Normansrule/skyforge-v18-falcon/docs/BUDGET.md

# Running budget: cost, mass, CG, hover and stability (generated)

> Generated by `tools/budget.py` from the BOM, the V18 mass model and the aero model. Re-run after any change.
> Basis: **MODEL (planning LW-PLA 0.80)**.

## Cost

| Bucket | Low USD | High USD |
|---|---|---|
| Aircraft subtotal (V18 rows + added rows, incl. installed FPV) | 816 | 1,353 |
| Contingency (15 % of low / 20 % of high) | 122 | 271 |
| Extras if not owned (radio, monitor, charger, tools) | 341 | 700 |
| **From scratch, excl. printer** | **1,279** | **2,324** |
| Remaining after owned items (none listed) | 1,279 | 2,324 |

V18 BOM aircraft subtotal for comparison: USD 728-1,221.

Spend by stage:

| Stage | Low | High |
|---|---|---|
| S0 | 103 | 187 |
| S1 | 43 | 66 |
| S2 | 338 | 587 |
| S3 | 120 | 218 |
| S5 | 95 | 130 |
| S6 | 42 | 66 |
| S7 | 52 | 112 |
| S8 | 281 | 501 |
| S10 | 83 | 186 |

## Mass and centre of gravity (V18 positions)

| LW-PLA case | Density g/cm3 | All-up g | CG x mm | CG y mm |
|---|---|---|---|---|
| best | 0.60 | 2,515 | 418.7 | -0.3 |
| planning | 0.80 | 2,724 | 418.4 | -0.2 |
| worst_solid_pla | 1.24 | 3,183 | 417.8 | -0.2 |

The old ~1.5 kg finished-aircraft claim is not supported. CG barely moves with density: hardware and skin are both aft.

## Hover

Rotor thrust centroid x330; CG x418.4.

| Motor | Hover thrust g | Bench max needed for PASS (<= 50 %) g | ...for FIX (<= 60 %) g |
|---|---|---|---|
| M1 | 11 | 23 | 19 |
| M2 | 1,351 | 2,701 | 2,251 |
| M3 | 13 | 26 | 21 |
| M4 | 1,349 | 2,698 | 2,248 |

A motor near 0 g means the CG sits on the other rotor row: the front pair is doing almost nothing.

## Wing-borne stability

Neutral-point band (vortex lattice on the V18 planform, `analysis/aero.json`): x285-x332; MAC 544 mm.

Static margin at the current CG: -24.6 % to -15.8 % MAC (negative = unstable). CG window for 5-12 % margin on the forward NP: x219-x257.

See `docs/BALANCE_AND_STABILITY.md` for the balance study.

## Gates

| ID | Gate | Value | Status | Basis |
|---|---|---|---|---|
| G1 | Hover balance: |CG x - rotor centroid x| | 88.4 mm | **STOP** | MODEL (planning LW-PLA 0.80) |
| G2 | Worst motor share of weight (M2) | 49.6 % | **STOP** | MODEL (planning LW-PLA 0.80) |
| G3 | Static margin, most forward neutral point | -24.6 % MAC | **STOP** | MODEL (planning LW-PLA 0.80); NP band x285-332 |
| G4 | Worst-motor hover fraction of measured max thrust | -  | **UNKNOWN** | Stage-2 bench |
| G5 | Hover endurance at 80% of 3300 mAh | - min | **UNKNOWN** | Stage-2 thrust table |
| G6 | Transition peak current vs XT90 class 90 A | - A | **UNKNOWN** | UNKNOWN until Stage 2 |
| G7 | Transition peak vs 70 % of battery label (132 A) | - A | **UNKNOWN** | UNKNOWN until Stage 2 |

**PASS** proceed; **FIX** change something and re-check; **STOP** do not buy the remaining motors or bulk-print until redesigned; **UNKNOWN** the measurement does not exist yet. G1-G3 are model gates (V18 geometry + BOM); G4-G7 need the Stage-2 bench.
