Normansrule/skyforge-v18-falcon/analysis/aero_span_loading.png

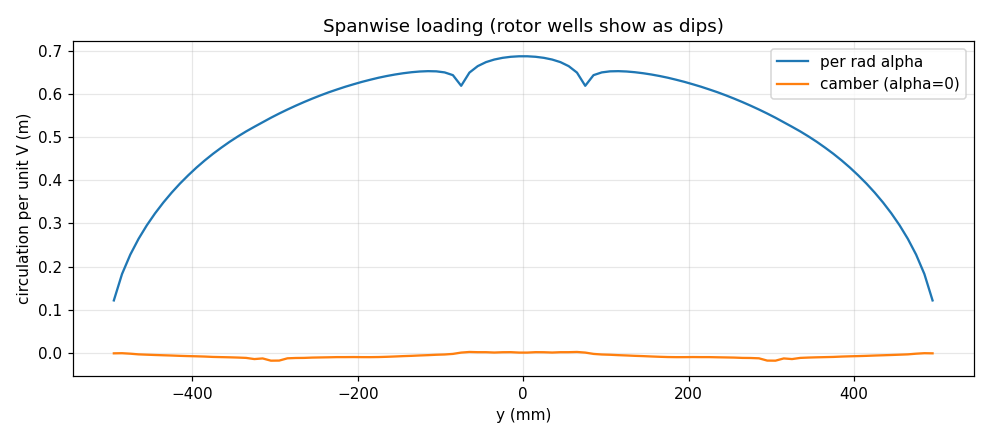
analysis/aero_span_loading.png
