Normansrule/skyforge-v18-falcon/analysis/view_v18.png

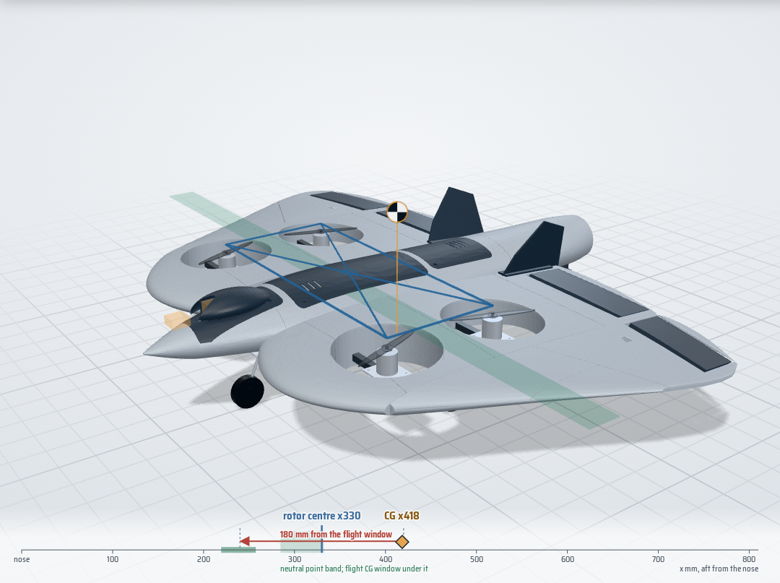
analysis/view_v18.png
