Normansrule/skyforge-v18-falcon/analysis/view_v19f_side.png

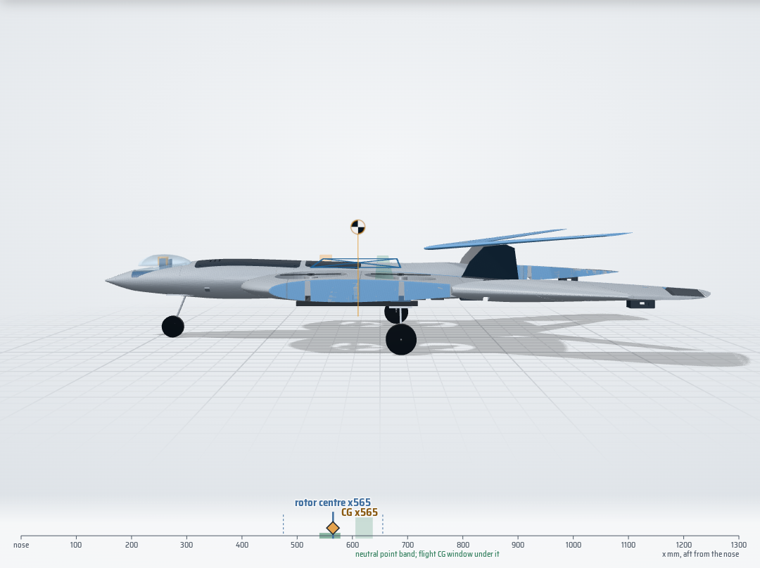
analysis/view_v19f_side.png
