Normansrule/skyforge-v18-falcon/analysis/view_v19r_side.png

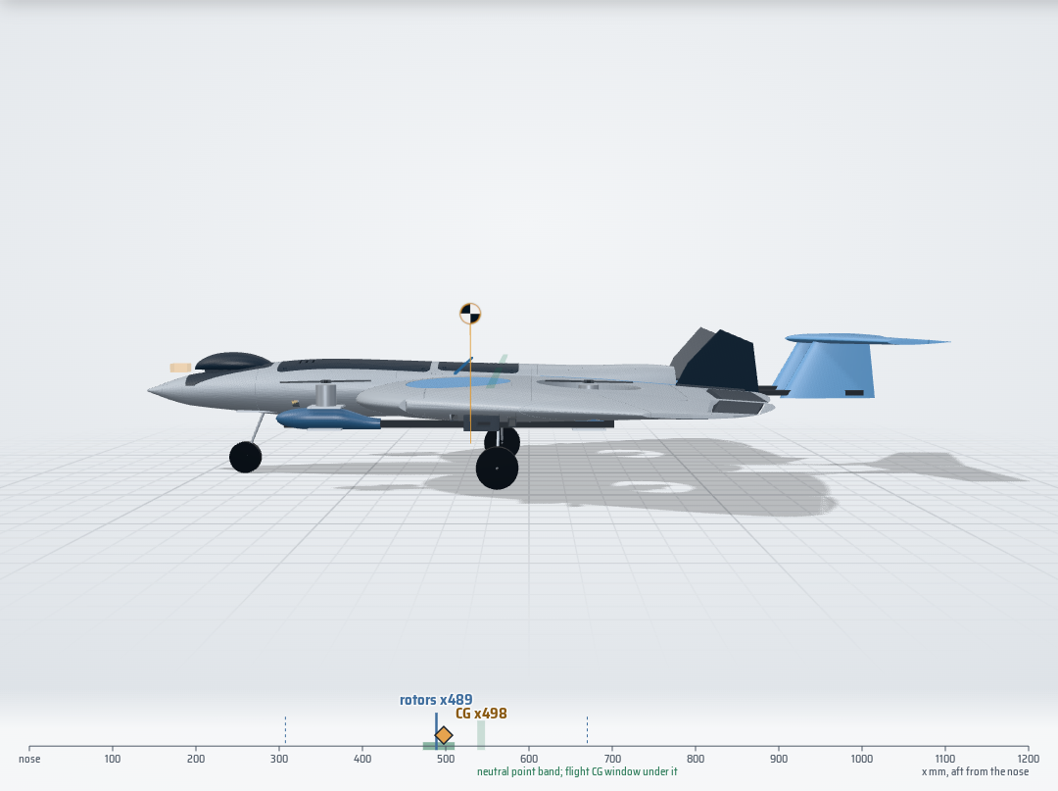
analysis/view_v19r_side.png
