Normansrule/skyforge-v18-falcon/analysis/view_v19r_top.png

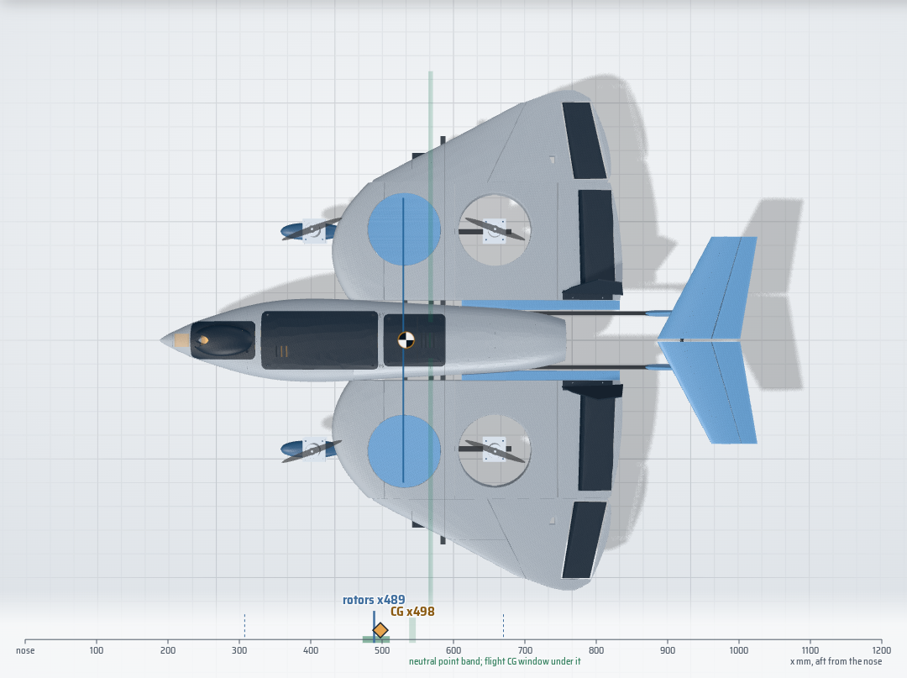
analysis/view_v19r_top.png
