Normansrule/skyforge-v18-falcon/analysis/view_v19s_side.png

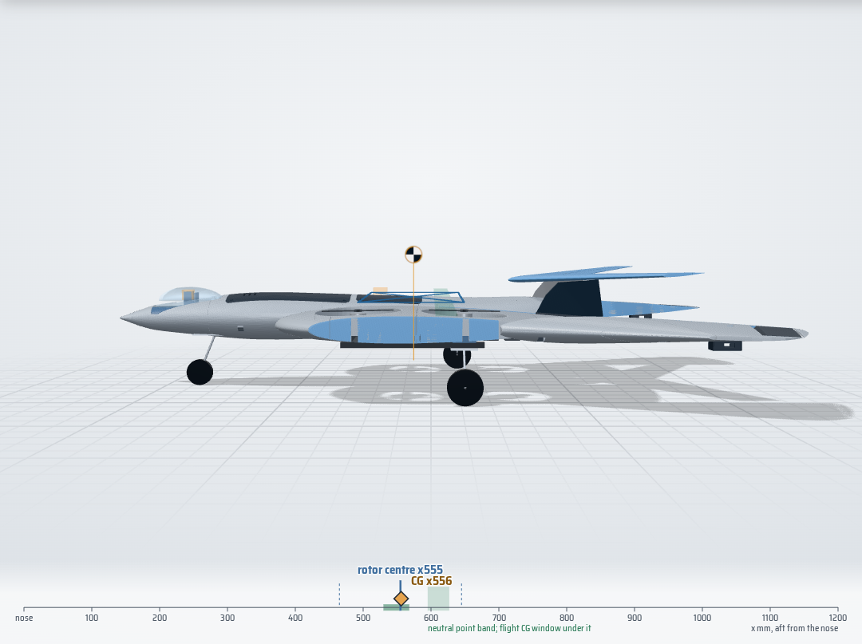
analysis/view_v19s_side.png
