Normansrule/skyforge-v18-falcon/analysis/view_v19w_side.png

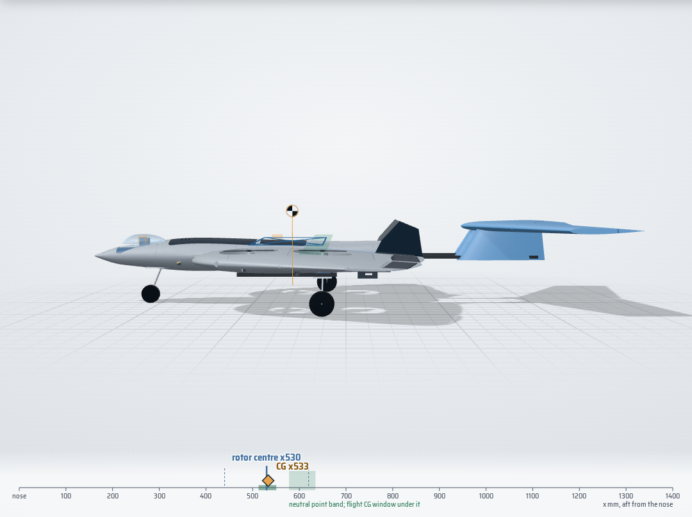
analysis/view_v19w_side.png
