Normansrule/skyforge-v18-falcon/analysis/view_v19w_top.png

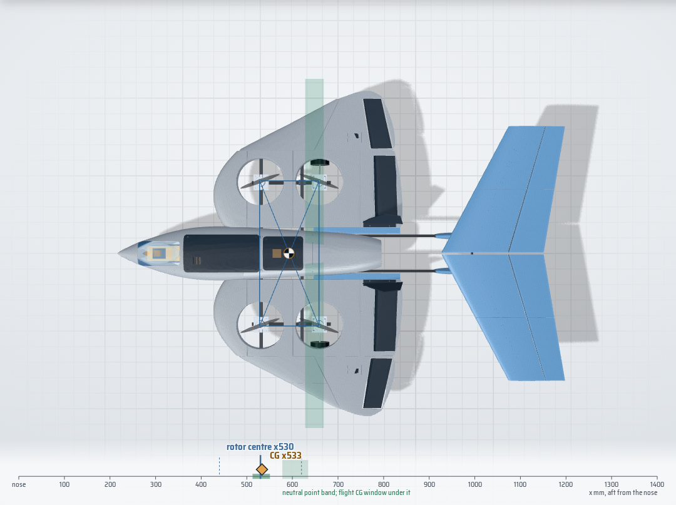
analysis/view_v19w_top.png
