Normansrule/skyforge-v18-falcon/docs/BOM.md

# Bill of materials (generated)

> Generated by `tools/budget.py` from `bom/bom.csv` - edit the CSV, not this file.
> V18 rows come from the V18 `BOM_AND_BUDGET.md` (kept in `cad/v18/`); **ADD** rows close the gaps the brief listed.
> Every named part is a **reference candidate** until fit and performance are verified. Whole-row USD planning
> allowances, excluding shipping/tax; verify variant, stock and price before buying.

Change tags: **ADD** new line, **FIX** tightened gate, **RESCOPE** split out of a vague V18 row, **KEEP** V18 row retained, **ALT** optional (not counted).
Placement: where the mass model puts the item - a V18 object, `xyz:` (assumed, not in the V18 model) or `geometry:` (mass from V18 meshes).

## Propulsion

| ID | Stage | Item | Reference candidate | Buy | Inst. | USD row | Unit g | Dimensions (mm) | Purchase gate | Change |
|---|---|---|---|---|---|---|---|---|---|---|
| P01 | S2 | Lift motor #1 (bench unit) | [EMAX ECO II 2207 2400KV](https://shop.emax-usa.com/products/eco-ii-2207-brushless-motor-1700kv-1900kv-2400kv) | 1 | 1 | 13-20 | 33 (e) | 16x16 mm factory M3 pattern (vendor); V18 envelope 28 dia x 29 | V18: 4S test candidate. Buy ONE first; check the 16x16 M3 pattern against the V18 G10 motor plate DXF. Bench at Stage 2 before buying P02. No 6S substitution. | FIX |
| P02 | S6 | Lift motors #2-4 | [EMAX ECO II 2207 2400KV](https://shop.emax-usa.com/products/eco-ii-2207-brushless-motor-1700kv-1900kv-2400kv) | 3 | 3 | 39-60 | 33 (e) | Same as P01 | Only after the Stage-2 hover gate PASSES in docs/BUDGET.md. Weigh each. | FIX |
| P03 | S2 | Spare lift motor | [EMAX ECO II 2207 2400KV](https://shop.emax-usa.com/products/eco-ii-2207-brushless-motor-1700kv-1900kv-2400kv) | 1 | 0 | 13-20 | 33 (e) | Same as P01 | Stage-2 budget spare. Not installed. | ADD |
| P04 | S2 | Lift props (2 x four-prop packs; second pack is spares) | [APC B5x3E-B4 four-prop pack (2 standard + 2 reverse)](https://www.apcprop.com/product/b5x3e-b4/) | 2 | 4 | 12-16 | 4.5 (e) | 127 dia, 5 mm bore (V18 BOM) | V18: verify hub retention. Never print flight props. Bench this exact prop at Stage 2. | KEEP |
| P06 | S2 | 4-in-1 lift ESC | [Hobbywing XRotor Micro 60A 4-in-1, 30902063](https://www.hobbywing.com/en/products/xrotor-micro-60a-4in1-blheli-32-dshot1200117) | 1 | 1 | 65-100 | 15 (v) | 52 x 42 x 6.6 published case; V18 keep-out 54 x 46 x 14 | Per-channel rating is NOT an aircraft bus rating. Stock XT60 not assumed adequate. Pad order is not assumed to match ArduPilot motor order. | KEEP |
| P07 | S5 | Rear EDF 64 mm | [Freewing E7206 64 mm 4S EDF Mark II](https://www.freewingmodel.com/747.html) | 1 | 1 | 60-85 | 142 (v) | 142 g published; V18 housing keep-out 72 dia x 78 | V18: factory ear and housing fit still required against EDF_saddle x2 and the outrigger connectors. | KEEP |
| P08 | S5 | EDF ESC | [Hobbywing Skywalker 60A V2](https://www.hobbywingdirect.com/products/skywalker-esc-60a) | 1 | 1 | 35-45 | 55 (e) | V18 keep-out 73 x 30 x 12 plus margin | Isolate the unused BEC positive; no reverse-thrust feature configured. Signal + ground only to FC S11. | KEEP |

## Power

| ID | Stage | Item | Reference candidate | Buy | Inst. | USD row | Unit g | Dimensions (mm) | Purchase gate | Change |
|---|---|---|---|---|---|---|---|---|---|---|
| E01 | S2 | Flight battery 4S 3300 mAh | [4S 3300 mAh standard LiPo (reference: CNHL 3300 4S 40C, 136 x 44 x 31, 369 g)](https://chinahobbyline.com/products/cnhl-3300mah-14-8v-4s-40c-lipo-battery-with-xt60-plug) | 1 | 1 | 40-65 | 369 (v) | Case <= 140 x 50 x 38 before leads (V18 keep-out 140 x 50 x 38) | Discharge rating, connector and wiring from MEASURED total current; the C label alone is insufficient. The keep-out leaves only ~4 mm of fore/aft slide, so the battery is not a CG trim tool in V18. | FIX |
| E02 | S2 | Total-current + voltage monitor (hall) | [Mauch 075 HS-200-LV (200 A, 2-6S)](https://mauch-electronic.com/products/075-hs-200-lv) | 1 | 1 | 41-55 | 20 (e) | Measure; 10 AWG leads + DF13-6 cable | Installed between battery and star so it sees lift + EDF + avionics. F405 WING ADC pads are 3.3 V: confirm output <= 3.3 V at max expected current. Calibrate against the bench watt meter at Stage 2. | ADD |
| E03 | ALT | Budget alternative total-current sensor | [ACS758LCB-200U hall module](https://www.amazon.com/s?k=ACS758LCB-200U+module) | 0 | 0 | 8-15 | 10 (e) | Module ~30 x 20 | Only if E02 is not bought. ~20 mV/A with ~0.6 V offset -> 3.3 V near 135 A; clamp to 3.3 V and calibrate against a meter. | ALT |
| E04 | S8 | Servo UBEC 5.0 V | [Hobbywing UBEC 10A AIR, 30603000](https://www.hobbywing.com/en/products/ubec-10a-2-6s152) | 1 | 1 | 25-40 | 36 (v) | 43.1 x 32.3 x 12.5 (vendor); V18 keep-out 48 x 38 x 16 | Set and MEASURE 5.0 V under servo load. Do not buy the CAR version (starts at 6 V). Feeds the isolated servo bus only. | KEEP |
| E05 | S2 | Main power connectors | [Genuine AMASS XT90 pairs x2, XT60 pairs x4, 3.5 mm bullets x6](https://www.amazon.com/s?k=amass+xt90+xt60+connector) | 1 | 1 | 15-25 | 30 (e) | - | Split out of the V18 'power harness' row. Final connector class from measured simultaneous current. | RESCOPE |
| E06 | S2 | Wire + heat-shrink | [Silicone wire 10 AWG (main/lift), 12 AWG (EDF), 18 AWG (branches), 22-26 AWG signal; heat-shrink](https://www.amazon.com/s?k=10+awg+silicone+wire+red+black) | 1 | 1 | 15-30 | 60 (e) | See docs/HARNESS.md cut list | Lengths from the V18-position harness cut list; gauge from measured current. | RESCOPE |
| E07 | S2 | Low-ESR bulk caps x2 (35 V) | [Panasonic FR 1000 uF 35 V (EEU-FR1V102) or equivalent](https://www.digikey.com/en/products/result?keywords=EEU-FR1V102) | 2 | 2 | 3-6 | 5 (e) | ~12.5 dia x 20 | One at the 4-in-1 input and one at the EDF ESC input; leads < 20 mm. | RESCOPE |
| E08 | S8 | FC-branch protection | [Inline mini-blade fuse holder (16-18 AWG) + 3 A and 5 A fuses](https://www.amazon.com/s?k=inline+mini+blade+fuse+holder+16+awg) | 1 | 1 | 4-8 | 4 (e) | - | Size after measuring avionics + video current at Stage 8. | RESCOPE |
| E09 | S8 | Video 5 V supply | [FC PDB VTX BEC set to 5 V (no purchase) or a separate 5 V micro-BEC](https://ardupilot.org/plane/docs/common-speedybeef405wing.html) | 0 | 0 | 0-8 | 0 (-) | - | MEASURE 5.0 V on the video rail BEFORE connecting the VTX (3.5-5.5 V max). | ADD |

## Avionics

| ID | Stage | Item | Reference candidate | Buy | Inst. | USD row | Unit g | Dimensions (mm) | Purchase gate | Change |
|---|---|---|---|---|---|---|---|---|---|---|
| A01 | S8 | Flight controller + PDB | [Original full-size SpeedyBee F405 WING APP (not MINI, not unverified V2)](https://ardupilot.org/plane/docs/common-speedybeef405wing.html) | 1 | 1 | 50-80 | 35 (v) | FC 52 x 32 x 19 (vendor); V18 keep-out 54 x 34 x 24 | ArduPlane target SpeedyBeeF405WING. PDB shunt (90 A cont) sees only the FC branch; E02 is the total monitor. | KEEP |
| A02 | S8 | FC isolation | [Printed TPU pad (cad/interface SF_FC_iso_pad_TPU) + spare M3 soft grommets](https://www.amazon.com/s?k=m3+anti+vibration+grommets+flight+controller) | 1 | 1 | 5-10 | 6 (e) | Fits the V18 FC keep-out | PASS: ArduPilot VIBE X/Y/Z < 30 m/s^2 and zero clip counts in a restrained props-on test. | ADD |
| A03 | S8 | ELRS receiver | [RadioMaster RP1 V2 2.4 GHz (FCC)](https://radiomasterrc.com/products/rp1-expresslrs-2-4ghz-nano-receiver) | 1 | 1 | 19-25 | 1.5 (e) | Nano receiver + U.FL antenna; V18 antenna keep-out 24 x 20 x 10 | 5 V CRSF. Keep the antenna clear of carbon shadow. Uses an ESP8285 MCU - the commercial link is not ESP-free. | KEEP |
| A04 | S8 | GNSS + compass | [Supported UART M10 GNSS + I2C compass, case <= 26 x 26 x 13](https://ardupilot.org/plane/docs/common-positioning-landing-page.html) | 1 | 1 | 25-50 | 10 (e) | V18 external keep-out 26 x 26 x 13 | V18: choose an actual compatible 5 V module; the old EOL module is not prescribed. Nonconductive external pad; check compass vs lift + EDF current (COMPASS_MOT). | KEEP |
| A05 | S8 | Airspeed sensor + pitot | [Matek ASPD-4525 with pitot and tubing](https://www.mateksys.com/?portfolio=aspd-4525) | 1 | 1 | 35-65 | 9 (e) | 4-5.5 V I2C module | Pitot outside rotor flow. Do not blow forcefully into the sensor. Location not in the V18 model - placement here is an assumption. | KEEP |
| A06 | S8 | Lost-model alarm (self-powered) | [VIFLY Finder 2](https://www.getfpv.com/vifly-finder-2-drone-buzzer.html) | 1 | 1 | 10-14 | 5 (e) | - | Tested at every power-up; never arm without it (docs/WIRING.md section 11). | ADD |
| A07 | S1 | Servo #1 (fit unit) | [EMAX ES08MA II metal gear micro servo](https://shop.emax-usa.com/products/emx-sv-0275-es08ma-ii-metal-analog-servo) | 1 | 1 | 8-18 | 12 (v) | ~32 x 11.5 x 24 body - verify in SP1 | V18: fit ONE before buying five. Substitutes (HS-65MG class) need dimensional AND torque checks. | KEEP |
| A08 | S7 | Servos #2-5 | [EMAX ES08MA II metal gear micro servo](https://shop.emax-usa.com/products/emx-sv-0275-es08ma-ii-metal-analog-servo) | 4 | 4 | 32-72 | 12 (v) | Same as A07 | Only after A07 passes fit + motion at Stage 1. Nose-steering servo location is not in the V18 model (placement assumed). | KEEP |
| A09 | S7 | Hinges, horns, pushrods, straps, backers | [12 hinges; 4 slop-free flight-control linkages; nose-steering linkage; 2 battery straps + nonslip pad; small balsa/G10 backers](https://www.amazon.com/s?k=rc+ca+hinges+pushrod+clevis+kit) | 1 | 1 | 20-40 | 40 (e) | - | V18 row. Horn/pushrod clearance is a Stage-7 check on BOTH sides; battery restraint is a Stage-4 pull test. | KEEP |
| A11 | S8 | Isolated servo 5 V bus | [Perfboard + 2.54 mm headers + 22 AWG](https://www.amazon.com/s?k=perfboard+2.54mm+header+pins) | 1 | 1 | 3-6 | 5 (e) | - | UBEC + only. FC servo-rail + is not connected to this bus. | ADD |

## FPV

| ID | Stage | Item | Reference candidate | Buy | Inst. | USD row | Unit g | Dimensions (mm) | Purchase gate | Change |
|---|---|---|---|---|---|---|---|---|---|---|
| V01 | S1 | FPV camera | [RunCam Phoenix 2 19 mm analog](https://shop.runcam.com/runcam-phoenix-2/) | 1 | 1 | 30-40 | 9 (v) | 19 x 19 body; V18 keep-out 20 x 19 x 19 | 5-36 V camera, ~9 g (V18 BOM). CAM_19mm_cradle fit + field-of-view check at Stage 1. | KEEP |
| V02 | S8 | VTX + antenna | [5 V analog VTX + matching antenna (electrical reference RunCam TX200U-US 3.5-5.5 V)](https://www.runcam.com/download/RunCam-TX200U-US-manual.pdf) | 1 | 1 | 25-45 | 6 (e) | V18 keep-out 42 x 26 x 14 | Replacement must be checked for input range, case, video and RF compliance. Antenna on BEFORE power. | KEEP |

## Structure

| ID | Stage | Item | Reference candidate | Buy | Inst. | USD row | Unit g | Dimensions (mm) | Purchase gate | Change |
|---|---|---|---|---|---|---|---|---|---|---|
| S01 | S3 | Carbon square tube 10 x 10 (2 x 1 m) | [Pultruded 10 x 10, ~1 mm wall candidate](https://carbonkevlarsupply.com/products/2-pultruded-square-carbon-fiber-tube-10mm-x-10mm-x-1000mm) | 2 | 1 | 22-40 | 0 (geo) | Cut list (cad/v18/carbon_cut_list.json): crossrails 620 + 820, gear crossbar 340 | V18 row (split by section). Measure wall/bore - 'round-centre' pultrusions differ from a 1 mm square wall. Prove clamp and bending strength at Stage 3. | KEEP |
| S02 | S3 | Carbon square tube 8 x 8 (2 x 1 m) | [Pultruded 8 x 8, ~1 mm wall candidate](https://carbonkevlarsupply.com/search?q=8mm+square+carbon+tube) | 2 | 1 | 18-30 | 0 (geo) | Cut list: keels 2 x 420, EDF outriggers 2 x 174 | Same as S01. | KEEP |
| S03 | S3 | G10/FR4 sheet stock 2.5 mm + 2.0 mm | [2.5 mm (motor plates/backers/gear plates/nose bridge) + 2.0 mm (cassette supports, EDF fittings)](https://www.beeplastic.com/products/g10-fr4-fiberglass-epoxy-plate-3240-0-5-5mm) | 1 | 1 | 20-40 | 0 (geo) | Cut profiles: cad/v18/dxf (15 plates, holes as modelled) | V18 row. Printed templates are not flight mounts. Imperial 3/32 in (2.38 mm) is not 2.5 mm - check screw lengths if substituted. | KEEP |
| R01 | S3 | Repo interface parts (installed) | [10 crossing-clamp plates + 2 belly straps (G10 2.0), 2 EDF ear brackets (PA-CF), FC TPU pad - see cad/interface/out/manifest.json](repo:cad/interface/out/manifest.json) | 0 | 1 | 0-0 | 30 (c) | G10 from S03 stock, filament from C05; mass = CAD volume x density | Cut/print at Stage 3 (clamps, straps), Stage 5 (EDF brackets) and Stage 8 (FC pad). Not part of the V18 1,297 cm3 polymer figure. | ADD |
| S05 | S3 | Fixed tricycle landing gear | [4 mm-class spring-steel legs; 2 x 60 mm mains, 1 x 48-50 mm nose; collars, axle bearings, steering tiller](https://www.amazon.com/s?k=rc+airplane+spring+steel+landing+gear+4mm) | 1 | 1 | 35-65 | 75 (e) | Main track 360 at crossbar x385; nose axle x150 (V18 layout) | V18 row. Proof-load at Stage 3 on the carbon/G10 structure without skin. | KEEP |

## Fasteners

| ID | Stage | Item | Reference candidate | Buy | Inst. | USD row | Unit g | Dimensions (mm) | Purchase gate | Change |
|---|---|---|---|---|---|---|---|---|---|---|
| F01 | S0 | M2 x 0.4 service screws + nuts + washers | [Stainless M2 x 6/8/10/12 + plain M2 hex nuts](https://www.amazon.com/s?k=m2+x+0.4+stainless+socket+screw+nut+kit) | 1 | 1 | 8-12 | 15 (e) | - | Confirm owned '2.0 mm' screws are M2 x 0.4 MACHINE screws. Nut pockets take plain M2 nuts - NOT heat-set inserts. Owned M2 reduces this row. | FIX |
| F02 | S3 | M3 structural hardware | [A2-70 / 10.9 M3 SHCS + nylocks + washers (motor plates use factory M3)](https://www.amazon.com/s?k=m3+socket+head+nylock+washer+kit) | 1 | 1 | 8-15 | 20 (e) | - | Check engagement through plate + rail + backing stack. | FIX |
| F03 | S3 | M4 gear hardware | [M4 SHCS + nylocks + washers](https://www.amazon.com/s?k=m4+socket+head+nylock+kit) | 1 | 1 | 4-8 | 10 (e) | - | Gear only. | FIX |

## Consumables

| ID | Stage | Item | Reference candidate | Buy | Inst. | USD row | Unit g | Dimensions (mm) | Purchase gate | Change |
|---|---|---|---|---|---|---|---|---|---|---|
| C01 | S3 | Threadlocker medium removable | [Loctite 243](https://www.amazon.com/s?k=loctite+243) | 1 | 0 | 5-8 | 0 (-) | - | Metal-to-metal only; keep off printed parts. | ADD |
| C02 | S1 | CA glue + activator | [Thin + medium CA + activator](https://www.amazon.com/s?k=ca+glue+thin+medium+activator) | 1 | 0 | 5-8 | 0 (-) | - | Adhesive mass is carried in C03. | ADD |
| C03 | S3 | Epoxy 5-min + 30-min | [5-min and 30-min epoxy](https://www.amazon.com/s?k=30+minute+epoxy+hobby) | 1 | 1 | 8-12 | 20 (e) | All installed adhesive | 30-min for carbon/G10 bonds. | ADD |
| C05 | S0 | Filament | [LW-PLA gray + charcoal for skins/controls; PETG for trays, cassettes, saddles, ducts; TPU 95A for the FC carrier](https://www.amazon.com/s?k=lw-pla+filament) | 1 | 0 | 35-55 | 0 (-) | Polymer mass from V18 volumes x calibrated density | V18 row split (adhesives itemized separately). Calibrate LW-PLA and WEIGH coupons at Stage 1. | RESCOPE |
| C07 | S6 | Clear cockpit window | [Thin clear PETG or polycarbonate sheet](https://www.amazon.com/s?k=clear+petg+sheet+0.5mm) | 1 | 1 | 3-6 | 4 (e) | - | V18 row. | KEEP |
| C06 | S10 | Light finish + decals | [Lightweight vinyl markings / thin paint](https://www.amazon.com/s?k=rc+airplane+vinyl+decal+sheet) | 1 | 1 | 3-6 | 8 (e) | - | Added last; reweigh and rebalance after. | KEEP |

## Extras

| ID | Stage | Item | Reference candidate | Buy | Inst. | USD row | Unit g | Dimensions (mm) | Purchase gate | Change |
|---|---|---|---|---|---|---|---|---|---|---|
| X01 | S0 | Digital calipers | [150 mm digital caliper](https://www.amazon.com/s?k=digital+caliper+150mm) | 1 | 0 | 15-30 | 0 (-) | - | Skip if owned. | KEEP |
| X02 | S0 | Scales | [0.1 g pocket scale + 5 kg kitchen scale](https://www.amazon.com/s?k=0.1g+digital+pocket+scale) | 1 | 0 | 15-30 | 0 (-) | - | Skip if owned. | KEEP |
| X03 | S2 | Multimeter | [Auto-ranging DMM](https://www.amazon.com/s?k=auto+ranging+multimeter) | 1 | 0 | 20-40 | 0 (-) | - | Skip if owned. | KEEP |
| X04 | S2 | Inline watt meter >= 100 A | [Inline power analyzer rated above measured peak](https://www.amazon.com/s?k=rc+watt+meter+150a) | 1 | 0 | 20-40 | 0 (-) | - | Reference for calibrating E02. | ADD |
| X05 | S2 | Guarded thrust stand (ESP-free) | [Arduino Nano + HX711 + 5 kg load cell + guard; firmware in firmware/thrust_stand](https://www.amazon.com/s?k=hx711+5kg+load+cell) | 1 | 0 | 25-60 | 0 (-) | - | Prop guard and clamping are mandatory; nobody in the prop plane. | ADD |
| X06 | S2 | Servo tester (bench throttle) | [3-mode PWM servo tester](https://www.amazon.com/s?k=servo+tester+pwm) | 1 | 0 | 6-10 | 0 (-) | - | Optional - the thrust-stand firmware can drive the ESC itself. | ADD |
| X07 | S2 | 4S balance charger + LiPo bag | [4S-capable balance charger and charging supplies](https://www.amazon.com/s?k=lipo+balance+charger+4s) | 1 | 0 | 50-100 | 0 (-) | - | Skip if owned. | KEEP |
| X08 | S8 | ELRS transmitter + batteries | [Compatible commercial ELRS 2.4 GHz transmitter](https://radiomasterrc.com/) | 1 | 0 | 80-150 | 0 (-) | - | Skip if owned. | KEEP |
| X09 | S10 | FPV monitor / goggles | [Analog 5.8 GHz monitor or goggles](https://www.getfpv.com/) | 1 | 0 | 80-180 | 0 (-) | - | First flights are NOT immersive FPV. | KEEP |
| X10 | S0 | Soldering station | [Temperature-controlled iron capable of 10 AWG](https://www.amazon.com/s?k=temperature+controlled+soldering+station+80w) | 1 | 0 | 30-60 | 0 (-) | - | Skip if owned. | KEEP |

Mass basis: (v) vendor listing, (e) estimate - weigh it, (geo) from V18 meshes. Measured masses go in `config/measurements.json`.
