Normansrule/skyforge-v18-falcon/bom/bom.csv

id | stage | group | item | reference_candidate | buy_qty | installed_qty | row_usd_low | row_usd_high | unit_mass_g | mass_basis | dims_mm | supplier | url | purchase_gate | change | placement
P01 | S2 | Propulsion | Lift motor #1 (bench unit) | EMAX ECO II 2207 2400KV | 1 | 1 | 13 | 20 | 33 | estimate | 16x16 mm factory M3 pattern (vendor); V18 envelope 28 dia x 29 | EMAX USA | https://shop.emax-usa.com/products/eco-ii-2207-brushless-motor-1700kv-1900kv-2400kv | V18: 4S test candidate. Buy ONE first; check the 16x16 M3 pattern against the V18 G10 motor plate DXF. Bench at Stage 2 before buying P02. No 6S substitution. | FIX | PURCHASE_M1_2207_envelope
P02 | S6 | Propulsion | Lift motors #2-4 | EMAX ECO II 2207 2400KV | 3 | 3 | 39 | 60 | 33 | estimate | Same as P01 | EMAX USA | https://shop.emax-usa.com/products/eco-ii-2207-brushless-motor-1700kv-1900kv-2400kv | Only after the Stage-2 hover gate PASSES in docs/BUDGET.md. Weigh each. | FIX | PURCHASE_M2_2207_envelope;PURCHASE_M3_2207_envelope;PURCHASE_M4_2207_envelope
P03 | S2 | Propulsion | Spare lift motor | EMAX ECO II 2207 2400KV | 1 | 0 | 13 | 20 | 33 | estimate | Same as P01 | EMAX USA | https://shop.emax-usa.com/products/eco-ii-2207-brushless-motor-1700kv-1900kv-2400kv | Stage-2 budget spare. Not installed. | ADD
P04 | S2 | Propulsion | Lift props (2 x four-prop packs; second pack is spares) | APC B5x3E-B4 four-prop pack (2 standard + 2 reverse) | 2 | 4 | 12 | 16 | 4.5 | estimate | 127 dia, 5 mm bore (V18 BOM) | APC Propellers | https://www.apcprop.com/product/b5x3e-b4/ | V18: verify hub retention. Never print flight props. Bench this exact prop at Stage 2. | KEEP | NO_PRINT_PURCHASED_PROP_M1_REFERENCE_ONLY;NO_PRINT_PURCHASED_PROP_M2_REFERENCE_ONLY;NO_PRINT_PURCHASED_PROP_M3_REFERENCE_ONLY;NO_PRINT_PURCHASED_PROP_M4_REFERENCE_ONLY
P06 | S2 | Propulsion | 4-in-1 lift ESC | Hobbywing XRotor Micro 60A 4-in-1, 30902063 | 1 | 1 | 65 | 100 | 15 | vendor | 52 x 42 x 6.6 published case; V18 keep-out 54 x 46 x 14 | Hobbywing | https://www.hobbywing.com/en/products/xrotor-micro-60a-4in1-blheli-32-dshot1200117 | Per-channel rating is NOT an aircraft bus rating. Stock XT60 not assumed adequate. Pad order is not assumed to match ArduPilot motor order. | KEEP | KEEP_OUT_LIFT_ESC_54x46x14
P07 | S5 | Propulsion | Rear EDF 64 mm | Freewing E7206 64 mm 4S EDF Mark II | 1 | 1 | 60 | 85 | 142 | vendor | 142 g published; V18 housing keep-out 72 dia x 78 | Freewing | https://www.freewingmodel.com/747.html | V18: factory ear and housing fit still required against EDF_saddle x2 and the outrigger connectors. | KEEP | KEEP_OUT_EDF_72mm_HOUSING_KEEP_OUT
P08 | S5 | Propulsion | EDF ESC | Hobbywing Skywalker 60A V2 | 1 | 1 | 35 | 45 | 55 | estimate | V18 keep-out 73 x 30 x 12 plus margin | Hobbywing Direct | https://www.hobbywingdirect.com/products/skywalker-esc-60a | Isolate the unused BEC positive; no reverse-thrust feature configured. Signal + ground only to FC S11. | KEEP | KEEP_OUT_EDF_ESC_73x30x12_plus_margin
E01 | S2 | Power | Flight battery 4S 3300 mAh | 4S 3300 mAh standard LiPo (reference: CNHL 3300 4S 40C, 136 x 44 x 31, 369 g) | 1 | 1 | 40 | 65 | 369 | vendor | Case <= 140 x 50 x 38 before leads (V18 keep-out 140 x 50 x 38) | CNHL | https://chinahobbyline.com/products/cnhl-3300mah-14-8v-4s-40c-lipo-battery-with-xt60-plug | Discharge rating, connector and wiring from MEASURED total current; the C label alone is insufficient. The keep-out leaves only ~4 mm of fore/aft slide, so the battery is not a CG trim tool in V18. | FIX | KEEP_OUT_BATTERY_MAX_140x50x38
E02 | S2 | Power | Total-current + voltage monitor (hall) | Mauch 075 HS-200-LV (200 A, 2-6S) | 1 | 1 | 41 | 55 | 20 | estimate | Measure; 10 AWG leads + DF13-6 cable | Mauch Electronic | https://mauch-electronic.com/products/075-hs-200-lv | Installed between battery and star so it sees lift + EDF + avionics. F405 WING ADC pads are 3.3 V: confirm output <= 3.3 V at max expected current. Calibrate against the bench watt meter at Stage 2. | ADD | xyz:287,0,10
E03 | ALT | Power | Budget alternative total-current sensor | ACS758LCB-200U hall module | 0 | 0 | 8 | 15 | 10 | estimate | Module ~30 x 20 | Amazon (commodity) | https://www.amazon.com/s?k=ACS758LCB-200U+module | Only if E02 is not bought. ~20 mV/A with ~0.6 V offset -> 3.3 V near 135 A; clamp to 3.3 V and calibrate against a meter. | ALT
E04 | S8 | Power | Servo UBEC 5.0 V | Hobbywing UBEC 10A AIR, 30603000 | 1 | 1 | 25 | 40 | 36 | vendor | 43.1 x 32.3 x 12.5 (vendor); V18 keep-out 48 x 38 x 16 | Hobbywing | https://www.hobbywing.com/en/products/ubec-10a-2-6s152 | Set and MEASURE 5.0 V under servo load. Do not buy the CAR version (starts at 6 V). Feeds the isolated servo bus only. | KEEP | KEEP_OUT_SERVO_BEC_48x38x16
E05 | S2 | Power | Main power connectors | Genuine AMASS XT90 pairs x2, XT60 pairs x4, 3.5 mm bullets x6 | 1 | 1 | 15 | 25 | 30 | estimate | - | Amazon (commodity) | https://www.amazon.com/s?k=amass+xt90+xt60+connector | Split out of the V18 'power harness' row. Final connector class from measured simultaneous current. | RESCOPE | KEEP_OUT_BATTERY_MAX_140x50x38:3;KEEP_OUT_LIFT_ESC_54x46x14:1;KEEP_OUT_EDF_ESC_73x30x12_plus_margin:1
E06 | S2 | Power | Wire + heat-shrink | Silicone wire 10 AWG (main/lift), 12 AWG (EDF), 18 AWG (branches), 22-26 AWG signal; heat-shrink | 1 | 1 | 15 | 30 | 60 | estimate | See docs/HARNESS.md cut list | Amazon (commodity) | https://www.amazon.com/s?k=10+awg+silicone+wire+red+black | Lengths from the V18-position harness cut list; gauge from measured current. | RESCOPE | KEEP_OUT_BATTERY_MAX_140x50x38:2;KEEP_OUT_LIFT_ESC_54x46x14:2;KEEP_OUT_EDF_ESC_73x30x12_plus_margin:2;KEEP_OUT_FC_54x34x24:1
E07 | S2 | Power | Low-ESR bulk caps x2 (35 V) | Panasonic FR 1000 uF 35 V (EEU-FR1V102) or equivalent | 2 | 2 | 3 | 6 | 5 | estimate | ~12.5 dia x 20 | Digi-Key | https://www.digikey.com/en/products/result?keywords=EEU-FR1V102 | One at the 4-in-1 input and one at the EDF ESC input; leads < 20 mm. | RESCOPE | KEEP_OUT_LIFT_ESC_54x46x14;KEEP_OUT_EDF_ESC_73x30x12_plus_margin
E08 | S8 | Power | FC-branch protection | Inline mini-blade fuse holder (16-18 AWG) + 3 A and 5 A fuses | 1 | 1 | 4 | 8 | 4 | estimate | - | Amazon (commodity) | https://www.amazon.com/s?k=inline+mini+blade+fuse+holder+16+awg | Size after measuring avionics + video current at Stage 8. | RESCOPE | KEEP_OUT_FC_54x34x24
E09 | S8 | Power | Video 5 V supply | FC PDB VTX BEC set to 5 V (no purchase) or a separate 5 V micro-BEC | 0 | 0 | 0 | 8 | 0 | none | - | ArduPilot docs | https://ardupilot.org/plane/docs/common-speedybeef405wing.html | MEASURE 5.0 V on the video rail BEFORE connecting the VTX (3.5-5.5 V max). | ADD
A01 | S8 | Avionics | Flight controller + PDB | Original full-size SpeedyBee F405 WING APP (not MINI, not unverified V2) | 1 | 1 | 50 | 80 | 35 | vendor | FC 52 x 32 x 19 (vendor); V18 keep-out 54 x 34 x 24 | ArduPilot docs | https://ardupilot.org/plane/docs/common-speedybeef405wing.html | ArduPlane target SpeedyBeeF405WING. PDB shunt (90 A cont) sees only the FC branch; E02 is the total monitor. | KEEP | KEEP_OUT_FC_54x34x24
A02 | S8 | Avionics | FC isolation | Printed TPU pad (cad/interface SF_FC_iso_pad_TPU) + spare M3 soft grommets | 1 | 1 | 5 | 10 | 6 | estimate | Fits the V18 FC keep-out | Amazon (commodity) | https://www.amazon.com/s?k=m3+anti+vibration+grommets+flight+controller | PASS: ArduPilot VIBE X/Y/Z < 30 m/s^2 and zero clip counts in a restrained props-on test. | ADD | KEEP_OUT_FC_54x34x24
A03 | S8 | Avionics | ELRS receiver | RadioMaster RP1 V2 2.4 GHz (FCC) | 1 | 1 | 19 | 25 | 1.5 | estimate | Nano receiver + U.FL antenna; V18 antenna keep-out 24 x 20 x 10 | RadioMaster | https://radiomasterrc.com/products/rp1-expresslrs-2-4ghz-nano-receiver | 5 V CRSF. Keep the antenna clear of carbon shadow. Uses an ESP8285 MCU - the commercial link is not ESP-free. | KEEP | KEEP_OUT_RX_antenna_free_zone
A04 | S8 | Avionics | GNSS + compass | Supported UART M10 GNSS + I2C compass, case <= 26 x 26 x 13 | 1 | 1 | 25 | 50 | 10 | estimate | V18 external keep-out 26 x 26 x 13 | ArduPilot docs | https://ardupilot.org/plane/docs/common-positioning-landing-page.html | V18: choose an actual compatible 5 V module; the old EOL module is not prescribed. Nonconductive external pad; check compass vs lift + EDF current (COMPASS_MOT). | KEEP | KEEP_OUT_GPS_mount_EXTERNAL_TBD
A05 | S8 | Avionics | Airspeed sensor + pitot | Matek ASPD-4525 with pitot and tubing | 1 | 1 | 35 | 65 | 9 | estimate | 4-5.5 V I2C module | Mateksys | https://www.mateksys.com/?portfolio=aspd-4525 | Pitot outside rotor flow. Do not blow forcefully into the sensor. Location not in the V18 model - placement here is an assumption. | KEEP | xyz:130,0,20
A06 | S8 | Avionics | Lost-model alarm (self-powered) | VIFLY Finder 2 | 1 | 1 | 10 | 14 | 5 | estimate | - | GetFPV | https://www.getfpv.com/vifly-finder-2-drone-buzzer.html | Tested at every power-up; never arm without it (docs/WIRING.md section 11). | ADD | xyz:520,25,12
A07 | S1 | Avionics | Servo #1 (fit unit) | EMAX ES08MA II metal gear micro servo | 1 | 1 | 8 | 18 | 12 | vendor | ~32 x 11.5 x 24 body - verify in SP1 | EMAX USA | https://shop.emax-usa.com/products/emx-sv-0275-es08ma-ii-metal-analog-servo | V18: fit ONE before buying five. Substitutes (HS-65MG class) need dimensional AND torque checks. | KEEP | SP1_side_servo_cassette_PRINT4_180
A08 | S7 | Avionics | Servos #2-5 | EMAX ES08MA II metal gear micro servo | 4 | 4 | 32 | 72 | 12 | vendor | Same as A07 | EMAX USA | https://shop.emax-usa.com/products/emx-sv-0275-es08ma-ii-metal-analog-servo | Only after A07 passes fit + motion at Stage 1. Nose-steering servo location is not in the V18 model (placement assumed). | KEEP | SP1_side_servo_cassette_PRINT4_-180;SP1_side_servo_cassette_PRINT4_360.222222222;SP1_side_servo_cassette_PRINT4_-360.222222222;xyz:200,0,-15
A09 | S7 | Avionics | Hinges, horns, pushrods, straps, backers | 12 hinges; 4 slop-free flight-control linkages; nose-steering linkage; 2 battery straps + nonslip pad; small balsa/G10 backers | 1 | 1 | 20 | 40 | 40 | estimate | - | Amazon (commodity) | https://www.amazon.com/s?k=rc+ca+hinges+pushrod+clevis+kit | V18 row. Horn/pushrod clearance is a Stage-7 check on BOTH sides; battery restraint is a Stage-4 pull test. | KEEP | FLAP_R:1;FLAP_L:1;ELEVON_R_falcon:1;ELEVON_L_falcon:1;KEEP_OUT_BATTERY_MAX_140x50x38:1
A11 | S8 | Avionics | Isolated servo 5 V bus | Perfboard + 2.54 mm headers + 22 AWG | 1 | 1 | 3 | 6 | 5 | estimate | - | Amazon (commodity) | https://www.amazon.com/s?k=perfboard+2.54mm+header+pins | UBEC + only. FC servo-rail + is not connected to this bus. | ADD | KEEP_OUT_SERVO_BEC_48x38x16
V01 | S1 | FPV | FPV camera | RunCam Phoenix 2 19 mm analog | 1 | 1 | 30 | 40 | 9 | vendor | 19 x 19 body; V18 keep-out 20 x 19 x 19 | RunCam | https://shop.runcam.com/runcam-phoenix-2/ | 5-36 V camera, ~9 g (V18 BOM). CAM_19mm_cradle fit + field-of-view check at Stage 1. | KEEP | KEEP_OUT_CAMERA_19mm
V02 | S8 | FPV | VTX + antenna | 5 V analog VTX + matching antenna (electrical reference RunCam TX200U-US 3.5-5.5 V) | 1 | 1 | 25 | 45 | 6 | estimate | V18 keep-out 42 x 26 x 14 | RunCam | https://www.runcam.com/download/RunCam-TX200U-US-manual.pdf | Replacement must be checked for input range, case, video and RF compliance. Antenna on BEFORE power. | KEEP | KEEP_OUT_VTX_42x26x14
S01 | S3 | Structure | Carbon square tube 10 x 10 (2 x 1 m) | Pultruded 10 x 10, ~1 mm wall candidate | 2 | 1 | 22 | 40 | 0 | geometry | Cut list (cad/v18/carbon_cut_list.json): crossrails 620 + 820, gear crossbar 340 | CarbonKevlarSupply | https://carbonkevlarsupply.com/products/2-pultruded-square-carbon-fiber-tube-10mm-x-10mm-x-1000mm | V18 row (split by section). Measure wall/bore - 'round-centre' pultrusions differ from a 1 mm square wall. Prove clamp and bending strength at Stage 3. | KEEP | geometry:carbon:10x10
S02 | S3 | Structure | Carbon square tube 8 x 8 (2 x 1 m) | Pultruded 8 x 8, ~1 mm wall candidate | 2 | 1 | 18 | 30 | 0 | geometry | Cut list: keels 2 x 420, EDF outriggers 2 x 174 | CarbonKevlarSupply | https://carbonkevlarsupply.com/search?q=8mm+square+carbon+tube | Same as S01. | KEEP | geometry:carbon:8x8
S03 | S3 | Structure | G10/FR4 sheet stock 2.5 mm + 2.0 mm | 2.5 mm (motor plates/backers/gear plates/nose bridge) + 2.0 mm (cassette supports, EDF fittings) | 1 | 1 | 20 | 40 | 0 | geometry | Cut profiles: cad/v18/dxf (15 plates, holes as modelled) | BeePlastic | https://www.beeplastic.com/products/g10-fr4-fiberglass-epoxy-plate-3240-0-5-5mm | V18 row. Printed templates are not flight mounts. Imperial 3/32 in (2.38 mm) is not 2.5 mm - check screw lengths if substituted. | KEEP | geometry:g10
R01 | S3 | Structure | Repo interface parts (installed) | 10 crossing-clamp plates + 2 belly straps (G10 2.0), 2 EDF ear brackets (PA-CF), FC TPU pad - see cad/interface/out/manifest.json | 0 | 1 | 0 | 0 | 30 | computed | G10 from S03 stock, filament from C05; mass = CAD volume x density | Made in this repo | repo:cad/interface/out/manifest.json | Cut/print at Stage 3 (clamps, straps), Stage 5 (EDF brackets) and Stage 8 (FC pad). Not part of the V18 1,297 cm3 polymer figure. | ADD | site:240,24,-19:2.8;site:240,-24,-19:2.8;site:420,24,-19:2.8;site:420,-24,-19:2.8;site:385,24,-31:2.8;site:385,-24,-31:2.8;site:695,54,0:3.7;site:695,-54,0:3.7;KEEP_OUT_FC_54x34x24:4.9
S05 | S3 | Structure | Fixed tricycle landing gear | 4 mm-class spring-steel legs; 2 x 60 mm mains, 1 x 48-50 mm nose; collars, axle bearings, steering tiller | 1 | 1 | 35 | 65 | 75 | estimate | Main track 360 at crossbar x385; nose axle x150 (V18 layout) | Amazon (commodity) | https://www.amazon.com/s?k=rc+airplane+spring+steel+landing+gear+4mm | V18 row. Proof-load at Stage 3 on the carbon/G10 structure without skin. | KEEP | PURCHASE_main_gear_leg_-1:11;PURCHASE_main_gear_leg_1:11;PURCHASE_nose_leg:10;PURCHASE_main_wheel_-1:14;PURCHASE_main_wheel_1:14;PURCHASE_nose_wheel:10;PURCHASE_OR_CUT_nose_gear_bridge:5
F01 | S0 | Fasteners | M2 x 0.4 service screws + nuts + washers | Stainless M2 x 6/8/10/12 + plain M2 hex nuts | 1 | 1 | 8 | 12 | 15 | estimate | - | Amazon (commodity) | https://www.amazon.com/s?k=m2+x+0.4+stainless+socket+screw+nut+kit | Confirm owned '2.0 mm' screws are M2 x 0.4 MACHINE screws. Nut pockets take plain M2 nuts - NOT heat-set inserts. Owned M2 reduces this row. | FIX | distributed:printed
F02 | S3 | Fasteners | M3 structural hardware | A2-70 / 10.9 M3 SHCS + nylocks + washers (motor plates use factory M3) | 1 | 1 | 8 | 15 | 20 | estimate | - | Amazon (commodity) | https://www.amazon.com/s?k=m3+socket+head+nylock+washer+kit | Check engagement through plate + rail + backing stack. | FIX | distributed:g10
F03 | S3 | Fasteners | M4 gear hardware | M4 SHCS + nylocks + washers | 1 | 1 | 4 | 8 | 10 | estimate | - | Amazon (commodity) | https://www.amazon.com/s?k=m4+socket+head+nylock+kit | Gear only. | FIX | G10_main_gear_left:1;PURCHASE_OR_CUT_main_gear_plate:1;PURCHASE_OR_CUT_nose_gear_bridge:1
C01 | S3 | Consumables | Threadlocker medium removable | Loctite 243 | 1 | 0 | 5 | 8 | 0 | none | - | Amazon (commodity) | https://www.amazon.com/s?k=loctite+243 | Metal-to-metal only; keep off printed parts. | ADD
C02 | S1 | Consumables | CA glue + activator | Thin + medium CA + activator | 1 | 0 | 5 | 8 | 0 | none | - | Amazon (commodity) | https://www.amazon.com/s?k=ca+glue+thin+medium+activator | Adhesive mass is carried in C03. | ADD
C03 | S3 | Consumables | Epoxy 5-min + 30-min | 5-min and 30-min epoxy | 1 | 1 | 8 | 12 | 20 | estimate | All installed adhesive | Amazon (commodity) | https://www.amazon.com/s?k=30+minute+epoxy+hobby | 30-min for carbon/G10 bonds. | ADD | distributed:printed
C05 | S0 | Consumables | Filament | LW-PLA gray + charcoal for skins/controls; PETG for trays, cassettes, saddles, ducts; TPU 95A for the FC carrier | 1 | 0 | 35 | 55 | 0 | none | Polymer mass from V18 volumes x calibrated density | Amazon / Polymaker / colorFabb | https://www.amazon.com/s?k=lw-pla+filament | V18 row split (adhesives itemized separately). Calibrate LW-PLA and WEIGH coupons at Stage 1. | RESCOPE
C07 | S6 | Consumables | Clear cockpit window | Thin clear PETG or polycarbonate sheet | 1 | 1 | 3 | 6 | 4 | estimate | - | Amazon (commodity) | https://www.amazon.com/s?k=clear+petg+sheet+0.5mm | V18 row. | KEEP | C1_service_cover
C06 | S10 | Consumables | Light finish + decals | Lightweight vinyl markings / thin paint | 1 | 1 | 3 | 6 | 8 | estimate | - | Amazon (commodity) | https://www.amazon.com/s?k=rc+airplane+vinyl+decal+sheet | Added last; reweigh and rebalance after. | KEEP | distributed:printed
X01 | S0 | Extras | Digital calipers | 150 mm digital caliper | 1 | 0 | 15 | 30 | 0 | none | - | Amazon (commodity) | https://www.amazon.com/s?k=digital+caliper+150mm | Skip if owned. | KEEP
X02 | S0 | Extras | Scales | 0.1 g pocket scale + 5 kg kitchen scale | 1 | 0 | 15 | 30 | 0 | none | - | Amazon (commodity) | https://www.amazon.com/s?k=0.1g+digital+pocket+scale | Skip if owned. | KEEP
X03 | S2 | Extras | Multimeter | Auto-ranging DMM | 1 | 0 | 20 | 40 | 0 | none | - | Amazon (commodity) | https://www.amazon.com/s?k=auto+ranging+multimeter | Skip if owned. | KEEP
X04 | S2 | Extras | Inline watt meter >= 100 A | Inline power analyzer rated above measured peak | 1 | 0 | 20 | 40 | 0 | none | - | Amazon (commodity) | https://www.amazon.com/s?k=rc+watt+meter+150a | Reference for calibrating E02. | ADD
X05 | S2 | Extras | Guarded thrust stand (ESP-free) | Arduino Nano + HX711 + 5 kg load cell + guard; firmware in firmware/thrust_stand | 1 | 0 | 25 | 60 | 0 | none | - | Amazon (commodity) | https://www.amazon.com/s?k=hx711+5kg+load+cell | Prop guard and clamping are mandatory; nobody in the prop plane. | ADD
X06 | S2 | Extras | Servo tester (bench throttle) | 3-mode PWM servo tester | 1 | 0 | 6 | 10 | 0 | none | - | Amazon (commodity) | https://www.amazon.com/s?k=servo+tester+pwm | Optional - the thrust-stand firmware can drive the ESC itself. | ADD
X07 | S2 | Extras | 4S balance charger + LiPo bag | 4S-capable balance charger and charging supplies | 1 | 0 | 50 | 100 | 0 | none | - | Amazon (commodity) | https://www.amazon.com/s?k=lipo+balance+charger+4s | Skip if owned. | KEEP
X08 | S8 | Extras | ELRS transmitter + batteries | Compatible commercial ELRS 2.4 GHz transmitter | 1 | 0 | 80 | 150 | 0 | none | - | RadioMaster | https://radiomasterrc.com/ | Skip if owned. | KEEP
X09 | S10 | Extras | FPV monitor / goggles | Analog 5.8 GHz monitor or goggles | 1 | 0 | 80 | 180 | 0 | none | - | GetFPV | https://www.getfpv.com/ | First flights are NOT immersive FPV. | KEEP
X10 | S0 | Extras | Soldering station | Temperature-controlled iron capable of 10 AWG | 1 | 0 | 30 | 60 | 0 | none | - | Amazon (commodity) | https://www.amazon.com/s?k=temperature+controlled+soldering+station+80w | Skip if owned. | KEEP
