Normansrule/skyforge-v18-falcon/cad/interface/out/step/SF_EDF_ear_bracket_lower.step

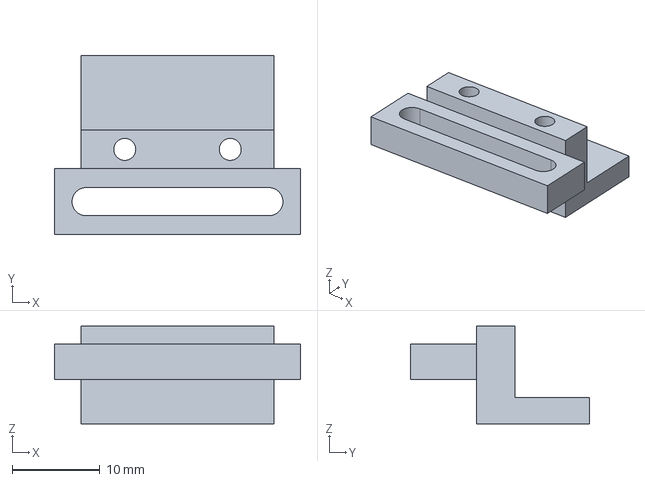
[picture p24: CAD file, 2026-10-02]
cad/interface/out/step/SF_EDF_ear_bracket_lower.step
28.0 x 20.4 x 11.1 mm
