Normansrule/skyforge-v18-falcon/cad/v19/v19a_long_nose/stl/NEW_F5_root_fairing_R.stl

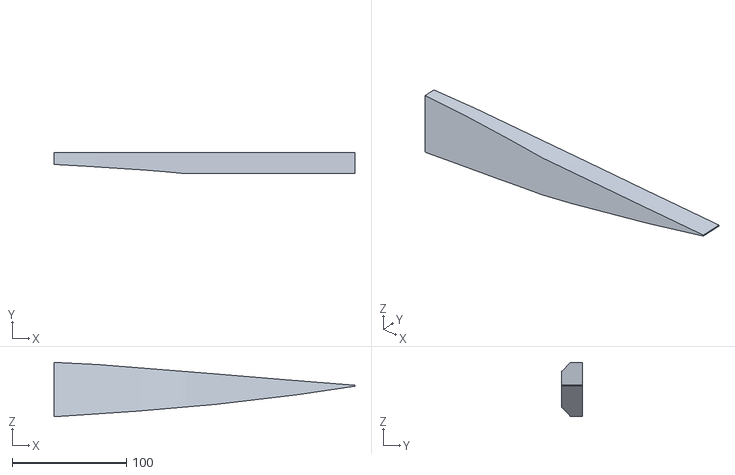
[picture p26: CAD file, 2026-10-04]
cad/v19/v19a_long_nose/stl/NEW_F5_root_fairing_R.stl
264.0 x 18.5 x 47.6
