Normansrule/skyforge-v18-falcon/cad/v19/v19b_falcon_tail/dxf/NEW_G10_nose_battery_floor.dxf

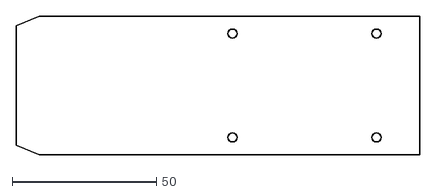
[picture p27: CAD file, 2026-10-06]
cad/v19/v19b_falcon_tail/dxf/NEW_G10_nose_battery_floor.dxf
140.0 x 48.0
