Normansrule/skyforge-v18-falcon/cad/v19/v19b_falcon_tail/stl/NEW_tail_stab_L1.stl

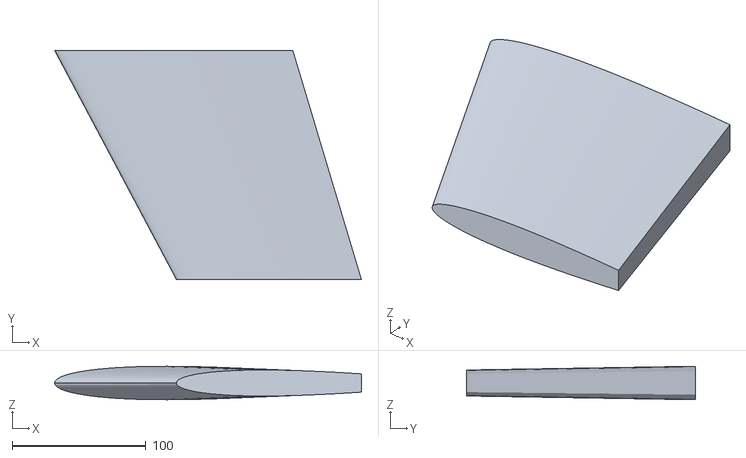
[picture p28: CAD file, 2026-10-04]
cad/v19/v19b_falcon_tail/stl/NEW_tail_stab_L1.stl
229.4 x 171.5 x 25.0
