Normansrule/skyforge-v18-falcon/cad/v19/v19c_forward_rotors/stl/NEW_front_motor_pod_R.stl

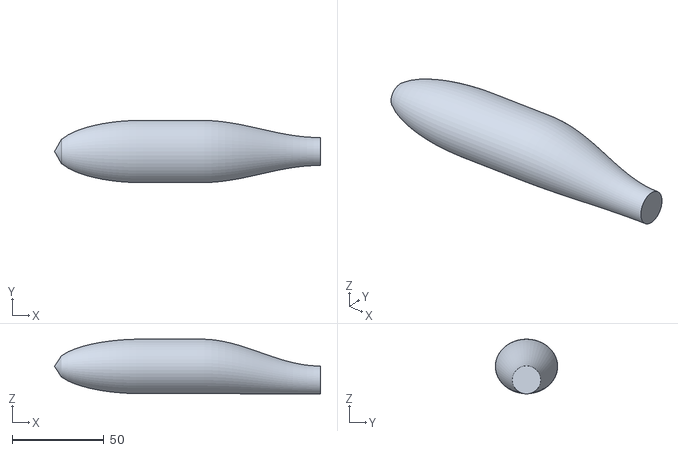
[picture p30: CAD file, 2026-10-04]
cad/v19/v19c_forward_rotors/stl/NEW_front_motor_pod_R.stl
145.0 x 34.0 x 29.9
