Normansrule/skyforge-v18-falcon/cad/v19/v19c_forward_rotors/v19c_forward_rotors_print_set.3mf

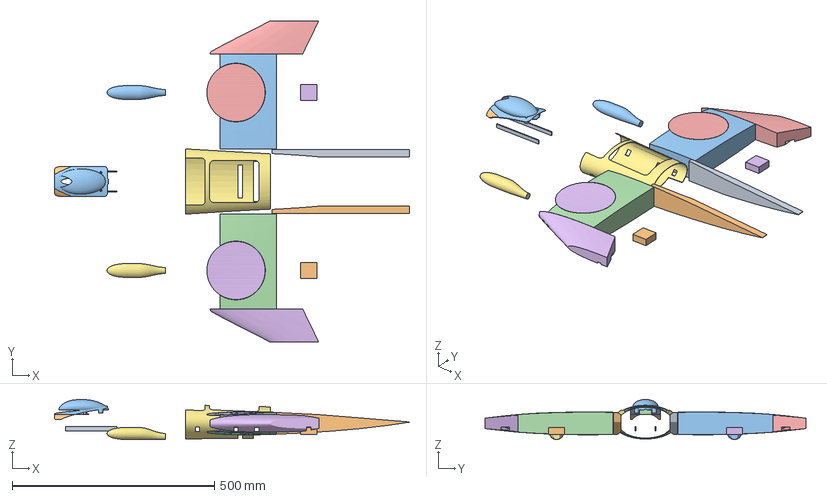
[picture p31: CAD file, 2026-10-06]
cad/v19/v19c_forward_rotors/v19c_forward_rotors_print_set.3mf
877.7 x 794.2 x 99.1 mm
NEW_nose_battery_rails
NEW_canopy_frame
NEW_canopy_clear_PETG
NEW_cockpit_camera_seat
NEW_front_well_cap_upper_R
NEW_front_well_cap_upper_L
NEW_front_well_cap_lower_R
NEW_front_well_cap_lower_L
NEW_F5_root_fairing_R
NEW_F5_root_fairing_L
NEW_front_motor_pod_R
NEW_boom_hanger_front_R
NEW_boom_hanger_rear_R
NEW_rear_motor_riser_R
NEW_front_motor_pod_L
NEW_boom_hanger_front_L
NEW_boom_hanger_rear_L
NEW_rear_motor_riser_L
WRB_hollow_wing__V19
WLB_hollow_wing__V19
WRE1_falcon_wing__V19
WLE1_falcon_wing__V19
F3_hollow_body__V19
