Normansrule/skyforge-v18-falcon/cad/v19/v19f_swift_stoop/stl/FIN_R__V19.stl

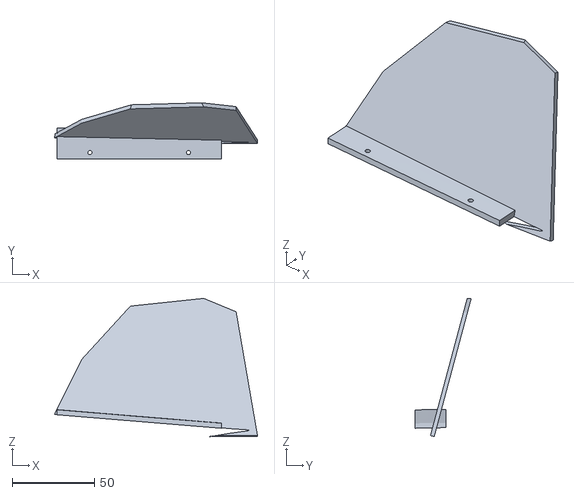
[picture p32: CAD file, 2026-10-06]
cad/v19/v19f_swift_stoop/stl/FIN_R__V19.stl
123.6 x 34.3 x 84.1
