Normansrule/skyforge-v18-falcon/cad/v19/v19f_swift_stoop/v19f_swift_stoop_print_set.3mf

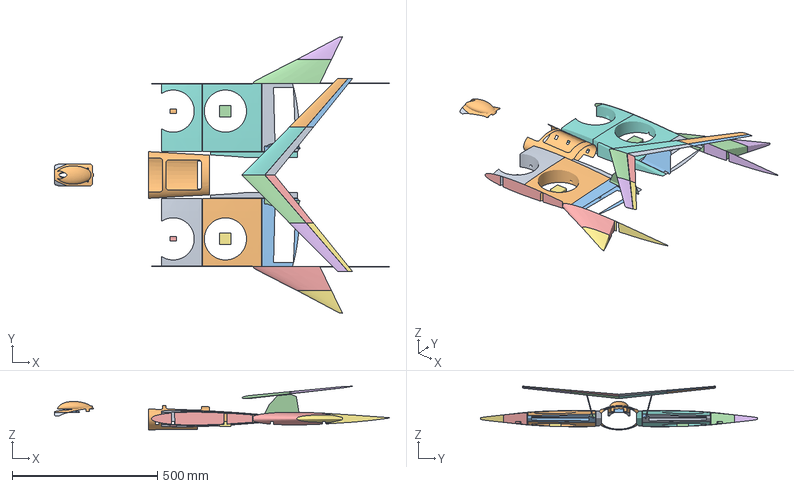
[picture p33: CAD file, 2026-10-06]
cad/v19/v19f_swift_stoop/v19f_swift_stoop_print_set.3mf
1153.7 x 954.1 x 150.7 mm
NEW_canopy_frame
NEW_canopy_clear_PETG
NEW_cockpit_camera_seat
NEW_wrist_cap_inner_R
NEW_wrist_cap_inner_L
NEW_wrist_cap_outer_R
NEW_wrist_cap_outer_L
NEW_F5_root_fairing_R
NEW_F5_root_fairing_L
NEW_boom_hanger_front_R
NEW_boom_hanger_rear_R
NEW_rear_motor_riser_R
NEW_boom_hanger_front_L
NEW_boom_hanger_rear_L
NEW_rear_motor_riser_L
NEW_crest_R1
NEW_crest_elevator_R1
NEW_crest_R2
NEW_crest_elevator_R2
NEW_crest_L1
NEW_crest_elevator_L1
NEW_crest_L2
NEW_crest_elevator_L2
WRC_hollow_wing__V19
WRD_hollow_wing__V19
WLC_hollow_wing__V19
WLD_hollow_wing__V19
WRE1_falcon_wing__V19
WLE1_falcon_wing__V19
WRE2_falcon_wing__V19
WLE2_falcon_wing__V19
WRB_hollow_wing__V19
WLB_hollow_wing__V19
F3_hollow_body__V19
FIN_R__V19
FIN_L__V19
