Normansrule/skyforge-v18-falcon/cad/v19/v19g_gyr_crest/stl/NEW_CF_crest_spar_R_6x4x405.stl

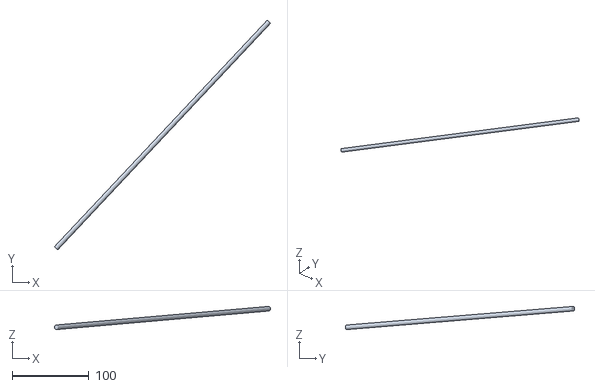
[picture p34: CAD file, 2026-10-06]
cad/v19/v19g_gyr_crest/stl/NEW_CF_crest_spar_R_6x4x405.stl
281.0 x 298.6 x 30.2
