Normansrule/skyforge-v18-falcon/cad/v19/v19r_boom_rotors/stl/NEW_tail_stab_L.stl

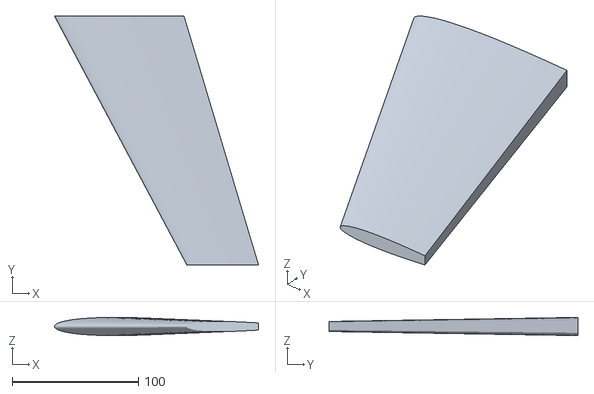
[picture p35: CAD file, 2026-10-04]
cad/v19/v19r_boom_rotors/stl/NEW_tail_stab_L.stl
161.5 x 197.0 x 14.4
