Normansrule/skyforge-v18-falcon/cad/v19/v19r_boom_rotors/v19r_boom_rotors_print_set.3mf

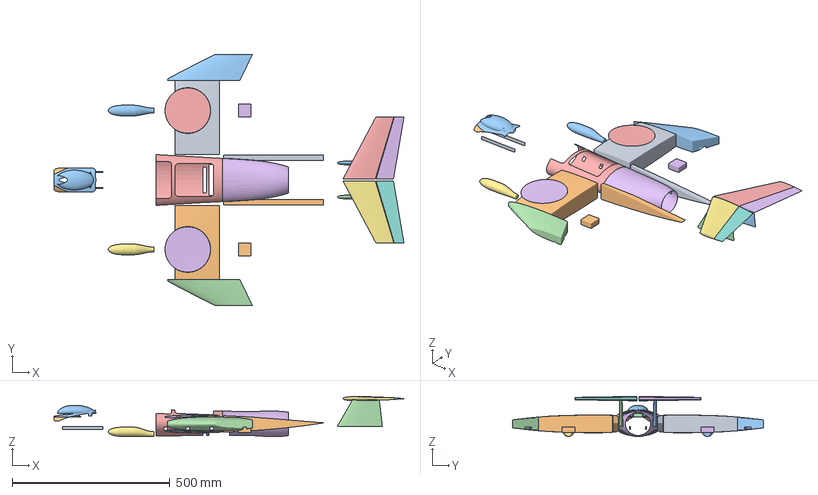
[picture p36: CAD file, 2026-10-06]
cad/v19/v19r_boom_rotors/v19r_boom_rotors_print_set.3mf
1108.8 x 794.2 x 127.7 mm
NEW_nose_battery_rails
NEW_canopy_frame
NEW_canopy_clear_PETG
NEW_cockpit_camera_seat
NEW_front_well_cap_upper_R
NEW_front_well_cap_upper_L
NEW_front_well_cap_lower_R
NEW_front_well_cap_lower_L
NEW_F5_root_fairing_R
NEW_F5_root_fairing_L
NEW_front_motor_pod_R
NEW_boom_hanger_front_R
NEW_boom_hanger_rear_R
NEW_rear_motor_riser_R
NEW_front_motor_pod_L
NEW_boom_hanger_front_L
NEW_boom_hanger_rear_L
NEW_rear_motor_riser_L
NEW_tail_fin_R
NEW_tail_fin_L
NEW_tail_stab_R
NEW_tail_elevator_R
NEW_tail_stab_L
NEW_tail_elevator_L
WRB_hollow_wing__V19
WLB_hollow_wing__V19
WRE1_falcon_wing__V19
WLE1_falcon_wing__V19
F3_hollow_body__V19
F4_hollow_body__V19
