Normansrule/skyforge-v18-falcon/cad/v19/v19s_stoop_crest/stl/NEW_crest_elevator_R1.stl

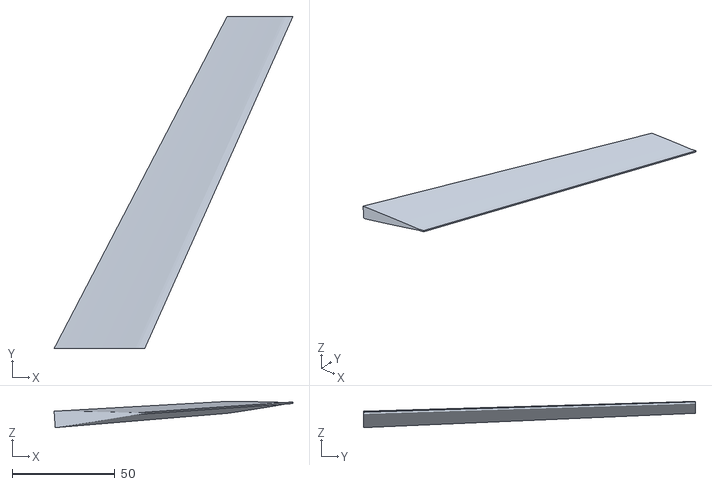
[picture p37: CAD file, 2026-10-06]
cad/v19/v19s_stoop_crest/stl/NEW_crest_elevator_R1.stl
116.2 x 161.5 x 12.8
