Normansrule/skyforge-v18-falcon/cad/v19/v19w_four_in_wings/stl/WLE1_falcon_wing__V19.stl

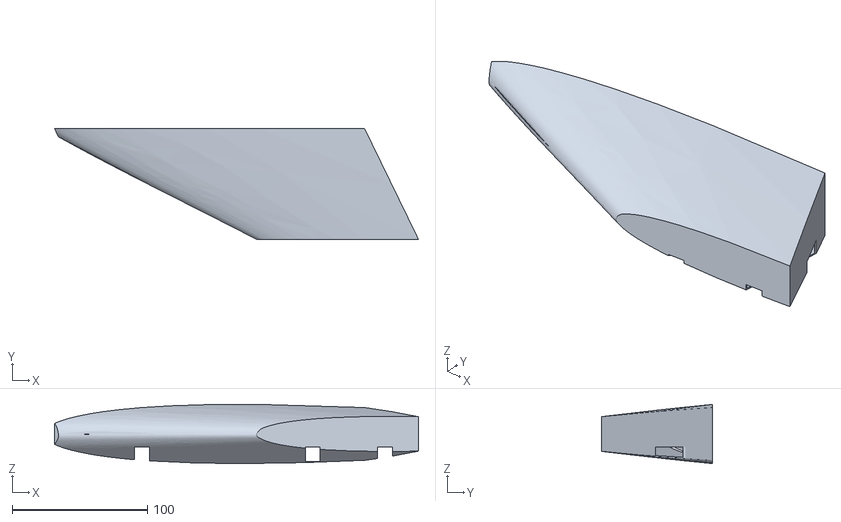
[picture p39: CAD file, 2026-10-04]
cad/v19/v19w_four_in_wings/stl/WLE1_falcon_wing__V19.stl
269.6 x 82.0 x 43.8
