Normansrule/skyforge-v18-falcon/cad/v19/v19w_four_in_wings/v19w_four_in_wings_print_set.3mf

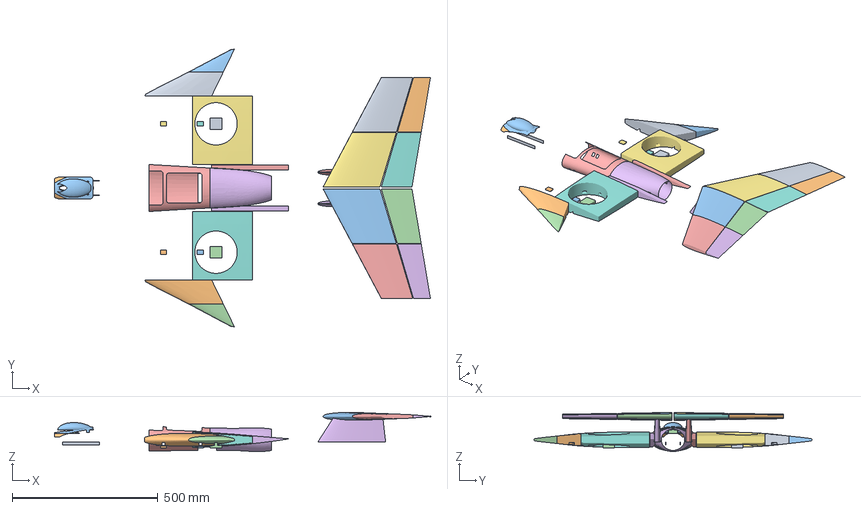
[picture p40: CAD file, 2026-10-06]
cad/v19/v19w_four_in_wings/v19w_four_in_wings_print_set.3mf
1288.8 x 954.1 x 134.2 mm
NEW_nose_battery_rails
NEW_canopy_frame
NEW_canopy_clear_PETG
NEW_cockpit_camera_seat
NEW_F5_root_fairing_R
NEW_F5_root_fairing_L
NEW_boom_hanger_front_R
NEW_boom_hanger_rear_R
NEW_rear_motor_riser_R
NEW_boom_hanger_front_L
NEW_boom_hanger_rear_L
NEW_rear_motor_riser_L
NEW_tail_fin_R
NEW_tail_fin_L
NEW_tail_stab_R1
NEW_tail_elevator_R1
NEW_tail_stab_R2
NEW_tail_elevator_R2
NEW_tail_stab_L1
NEW_tail_elevator_L1
NEW_tail_stab_L2
NEW_tail_elevator_L2
WRC_hollow_wing__V19
WLC_hollow_wing__V19
WRE1_falcon_wing__V19
WLE1_falcon_wing__V19
WRE2_falcon_wing__V19
WLE2_falcon_wing__V19
F3_hollow_body__V19
F4_hollow_body__V19
