Normansrule/skyforge-v18-falcon/cad/interface/out/step/SF_FC_iso_pad_TPU.step

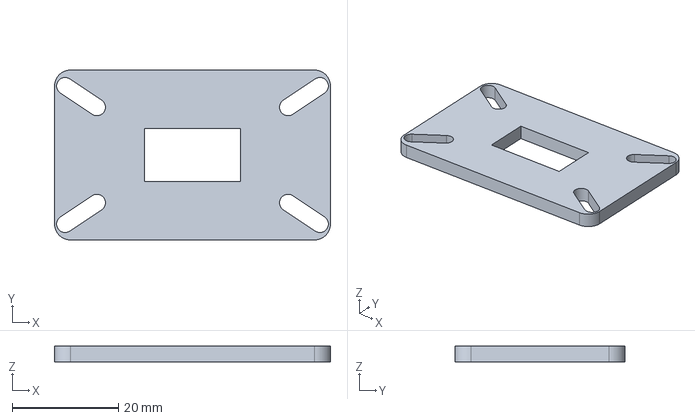
[picture p41: CAD file, 2026-10-02]
cad/interface/out/step/SF_FC_iso_pad_TPU.step
52.0 x 32.0 x 3.00 mm
