Normansrule/skyforge-v18-falcon/cad/v19/v19a_long_nose/stl/NEW_well_fill_R.stl

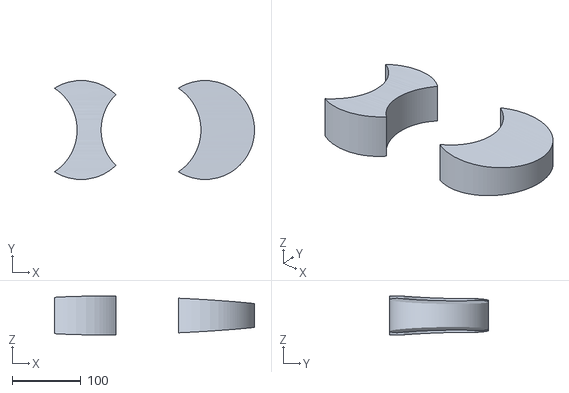
[picture p42: CAD file, 2026-10-04]
cad/v19/v19a_long_nose/stl/NEW_well_fill_R.stl
290.7 x 143.3 x 56.6
