Normansrule/skyforge-v18-falcon/cad/v19/v19b_falcon_tail/stl/NEW_tail_elevator_R2.stl

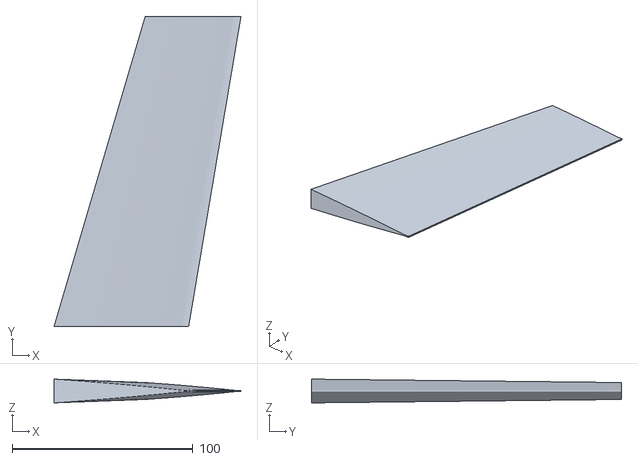
[picture p43: CAD file, 2026-10-04]
cad/v19/v19b_falcon_tail/stl/NEW_tail_elevator_R2.stl
103.4 x 171.5 x 13.2
