Normansrule/skyforge-v18-falcon/cad/v19/v19c_forward_rotors/stl/NEW_CF_rotor_boom_L_10x10x523.stl

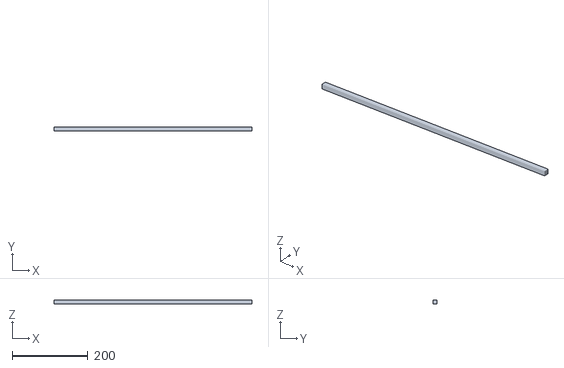
[picture p44: CAD file, 2026-10-04]
cad/v19/v19c_forward_rotors/stl/NEW_CF_rotor_boom_L_10x10x523.stl
522.5 x 10.0 x 10.0
