Normansrule/skyforge-v18-falcon/cad/v19/v19f_swift_stoop/stl/NEW_crest_elevator_R2.stl

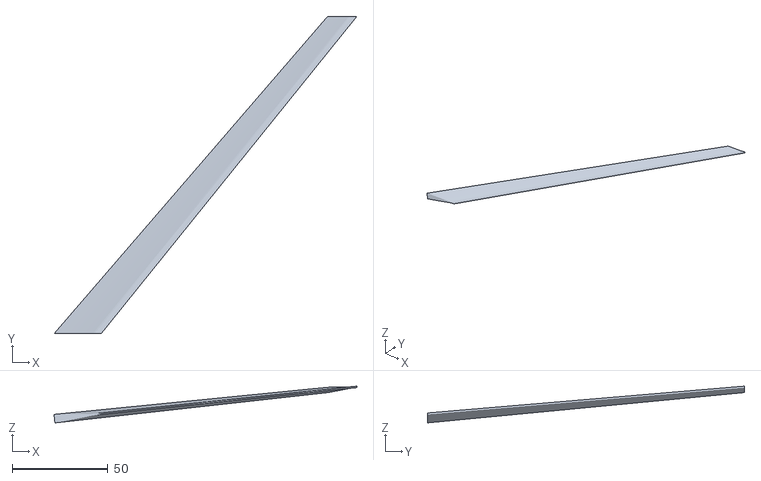
[picture p45: CAD file, 2026-10-06]
cad/v19/v19f_swift_stoop/stl/NEW_crest_elevator_R2.stl
158.0 x 165.6 x 19.2
