Normansrule/skyforge-v18-falcon/cad/v19/v19g_gyr_crest/stl/NEW_crest_elevator_L1.stl

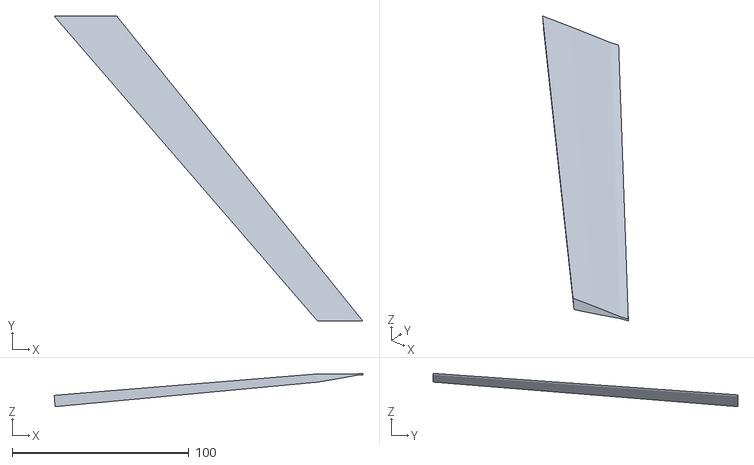
[picture p46: CAD file, 2026-10-06]
cad/v19/v19g_gyr_crest/stl/NEW_crest_elevator_L1.stl
174.8 x 172.7 x 18.9
