Normansrule/skyforge-v18-falcon/cad/v19/v19s_stoop_crest/stl/FIN_R__V19.stl

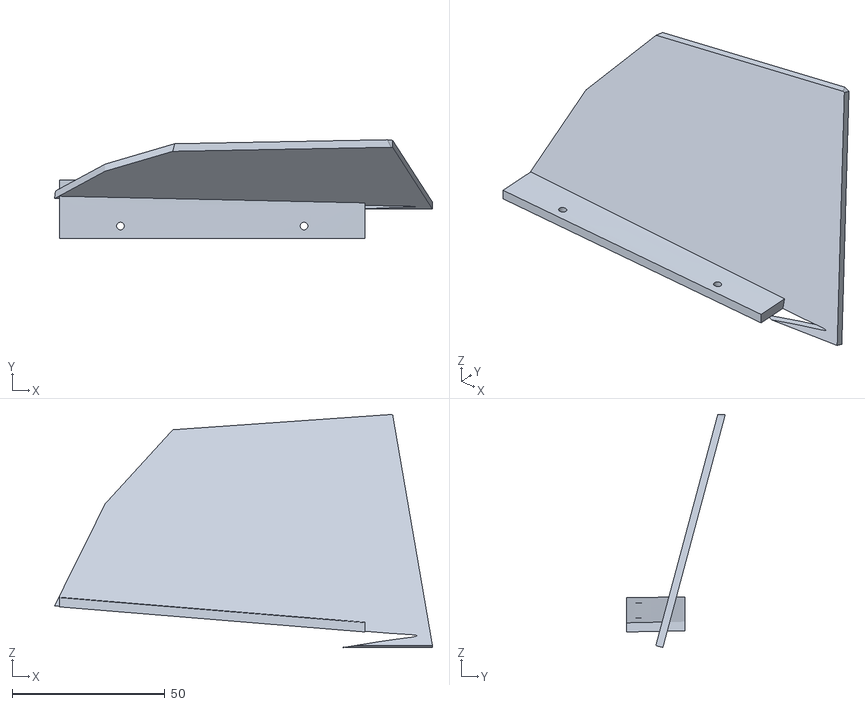
[picture p47: CAD file, 2026-10-06]
cad/v19/v19s_stoop_crest/stl/FIN_R__V19.stl
123.6 x 32.2 x 76.2
