Normansrule/skyforge-v18-falcon/cad/v19/v19w_four_in_wings/stl/NEW_tail_stab_L2.stl

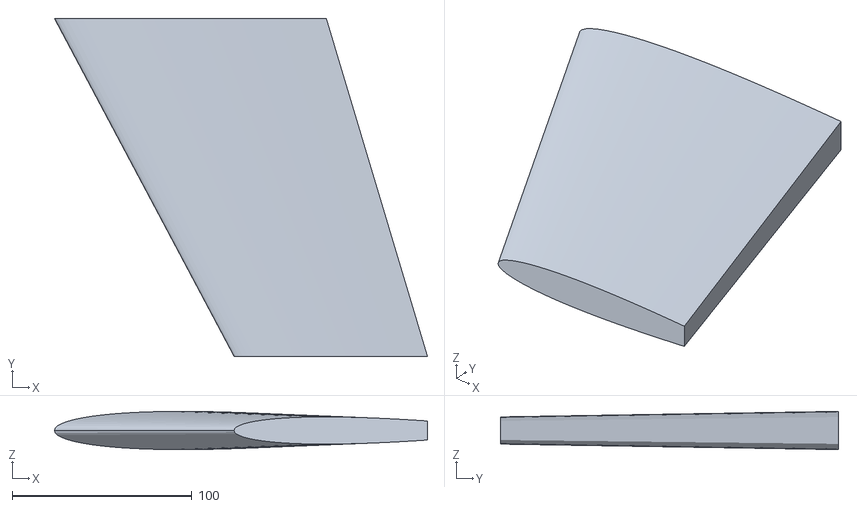
[picture p48: CAD file, 2026-10-04]
cad/v19/v19w_four_in_wings/stl/NEW_tail_stab_L2.stl
207.7 x 188.0 x 21.3
