Normansrule/skyforge-v18-falcon/cad/interface/out/step/SF_EDF_ear_bracket_upper.step

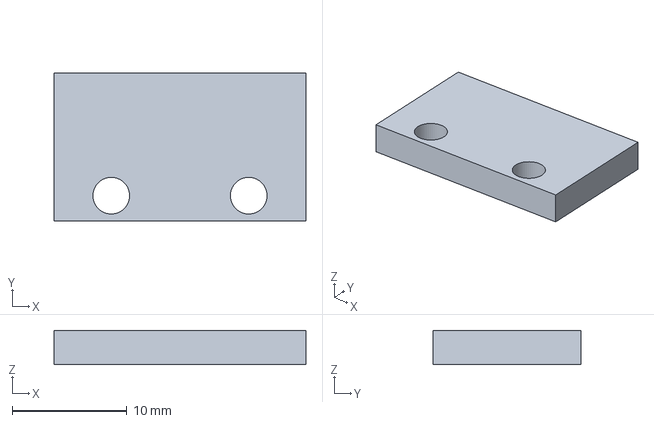
[picture p49: CAD file, 2026-10-02]
cad/interface/out/step/SF_EDF_ear_bracket_upper.step
22.0 x 12.9 x 3.00 mm
