Normansrule/skyforge-v18-falcon/cad/v19/v19b_falcon_tail/stl/NEW_tail_stab_R2.stl

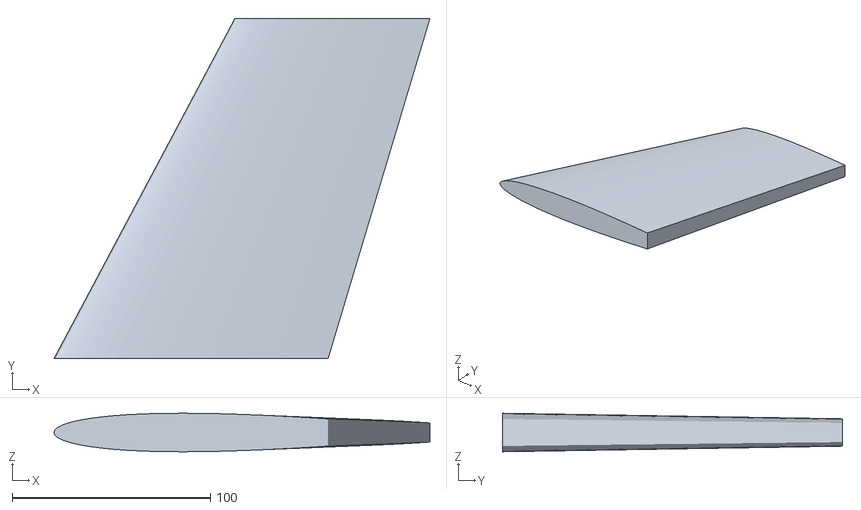
[picture p50: CAD file, 2026-10-04]
cad/v19/v19b_falcon_tail/stl/NEW_tail_stab_R2.stl
189.5 x 171.5 x 19.4
