Normansrule/skyforge-v18-falcon/cad/v19/v19f_swift_stoop/stl/NEW_CF_wrist_spar_R_10x10x254.stl

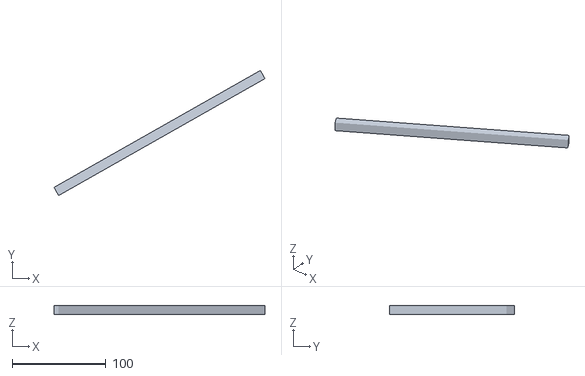
[picture p51: CAD file, 2026-10-06]
cad/v19/v19f_swift_stoop/stl/NEW_CF_wrist_spar_R_10x10x254.stl
225.5 x 133.7 x 10.0
