Normansrule/skyforge-v18-falcon/cad/v19/v19r_boom_rotors/stl/NEW_tail_elevator_L.stl

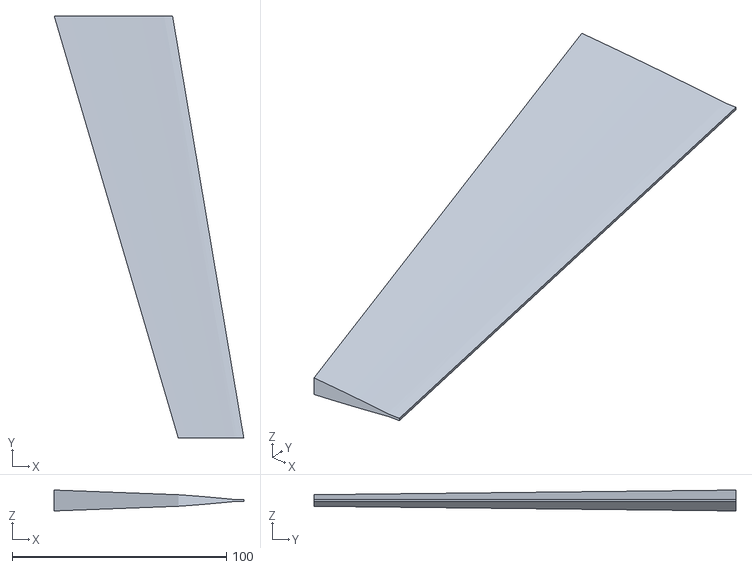
[picture p52: CAD file, 2026-10-04]
cad/v19/v19r_boom_rotors/stl/NEW_tail_elevator_L.stl
88.5 x 197.0 x 9.77
