Normansrule/skyforge-v18-falcon/cad/v19/v19s_stoop_crest/stl/NEW_rear_motor_riser_R.stl

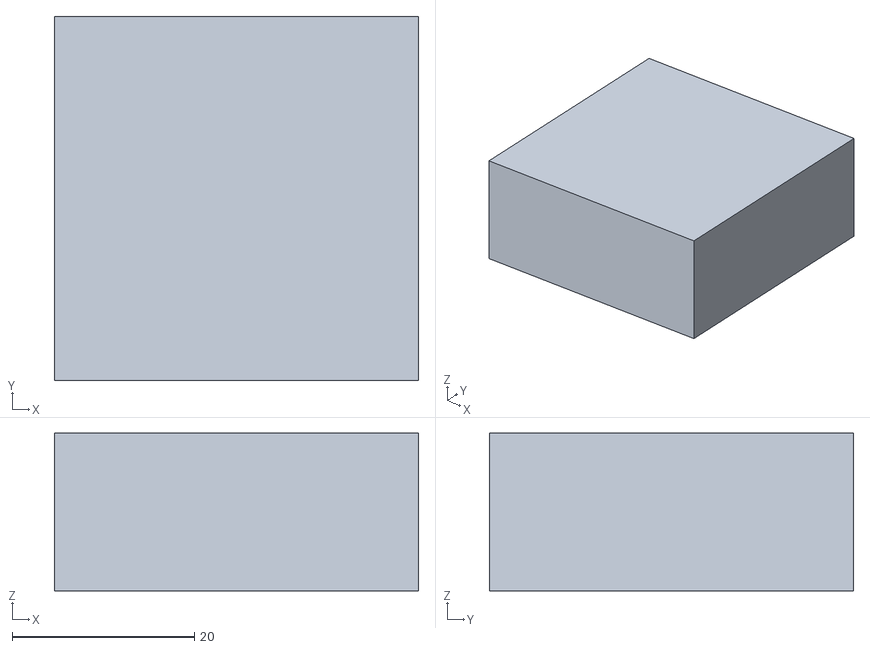
[picture p53: CAD file, 2026-10-06]
cad/v19/v19s_stoop_crest/stl/NEW_rear_motor_riser_R.stl
40.0 x 40.0 x 17.4
