Normansrule/skyforge-v18-falcon/cad/v19/v19w_four_in_wings/stl/WRE2_falcon_wing__V19.stl

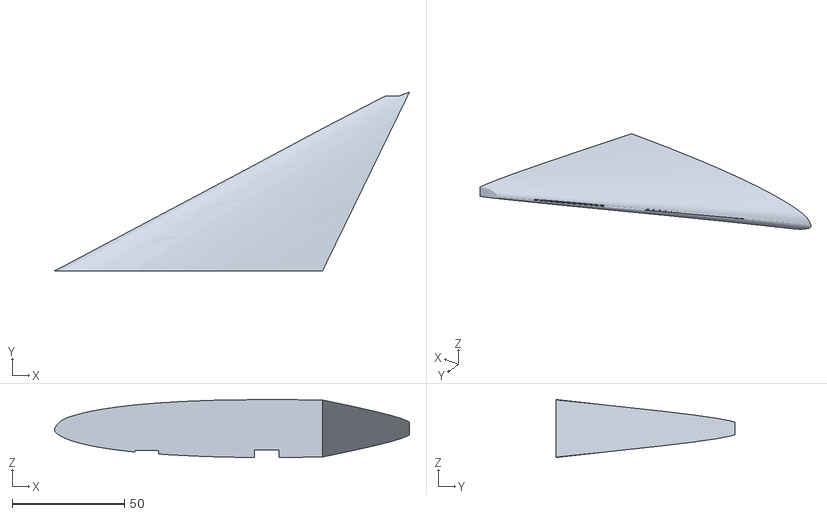
[picture p54: CAD file, 2026-10-04]
cad/v19/v19w_four_in_wings/stl/WRE2_falcon_wing__V19.stl
158.3 x 79.7 x 25.9
