Normansrule/skyforge-v18-falcon/cad/interface/out/step/SF_XC_crossing_clamp_G10_2p0.step

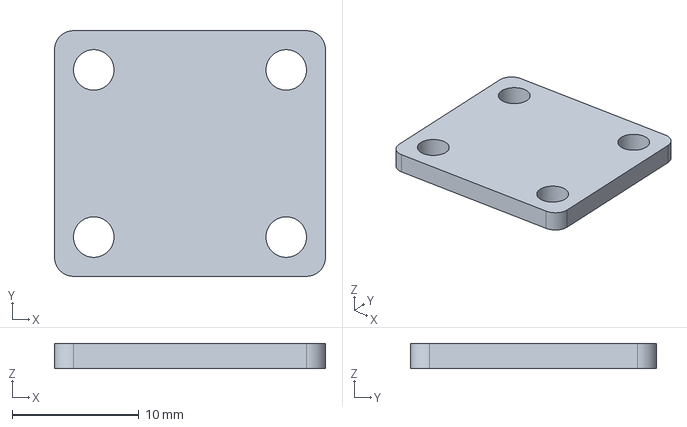
[picture p55: CAD file, 2026-10-02]
cad/interface/out/step/SF_XC_crossing_clamp_G10_2p0.step
21.4 x 19.4 x 2.00 mm
