Normansrule/skyforge-v18-falcon/cad/v19/v19a_long_nose/stl/NEW_leading_edge_glove_L.stl

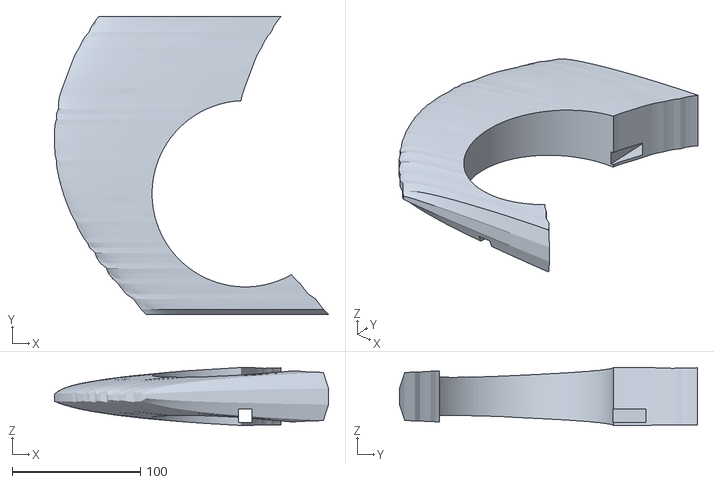
[picture p56: CAD file, 2026-10-04]
cad/v19/v19a_long_nose/stl/NEW_leading_edge_glove_L.stl
213.4 x 232.0 x 45.3
