Normansrule/skyforge-v18-falcon/cad/v19/v19b_falcon_tail/stl/NEW_tail_elevator_R1.stl

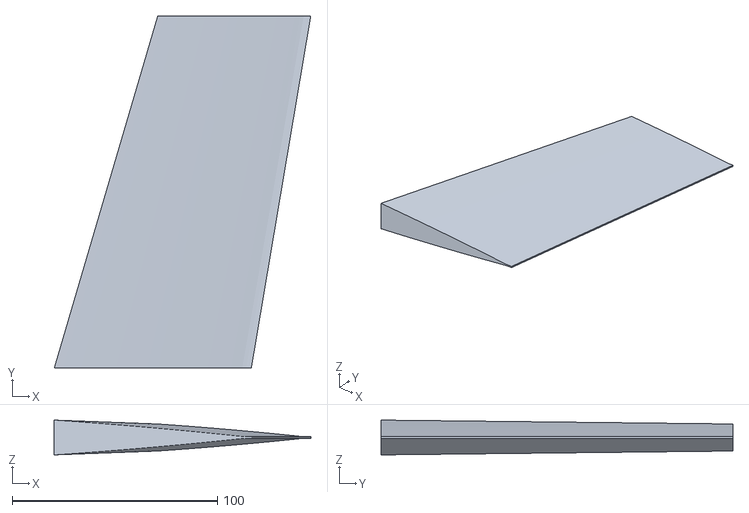
[picture p57: CAD file, 2026-10-04]
cad/v19/v19b_falcon_tail/stl/NEW_tail_elevator_R1.stl
124.9 x 171.5 x 17.0
