Normansrule/skyforge-v18-falcon/cad/v19/v19c_forward_rotors/stl/F3_hollow_body__V19.stl

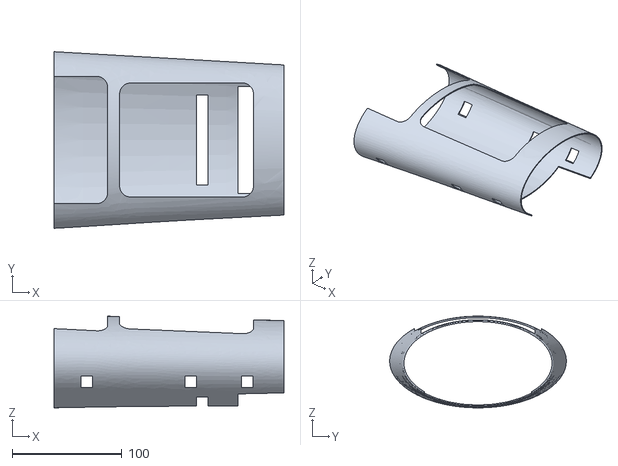
[picture p58: CAD file, 2026-10-04]
cad/v19/v19c_forward_rotors/stl/F3_hollow_body__V19.stl
209.8 x 161.1 x 83.6
