Normansrule/skyforge-v18-falcon/cad/v19/v19f_swift_stoop/stl/NEW_wrist_cap_outer_R.stl

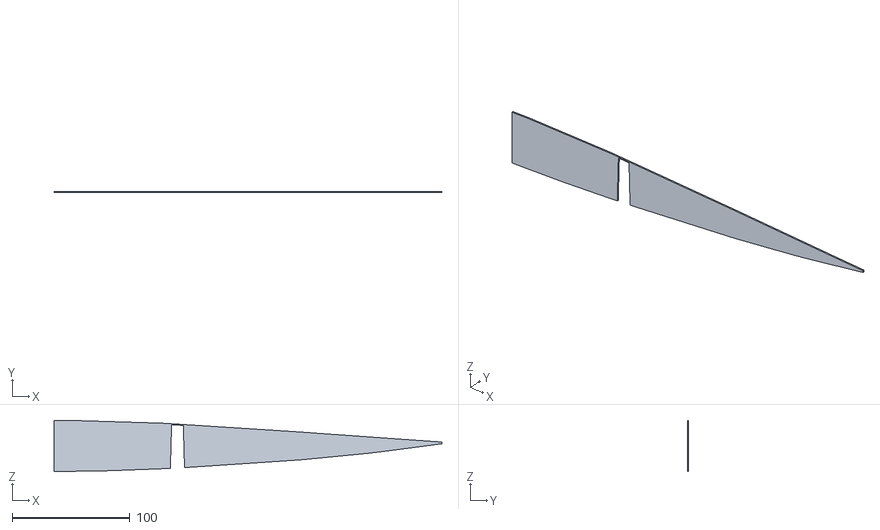
[picture p59: CAD file, 2026-10-06]
cad/v19/v19f_swift_stoop/stl/NEW_wrist_cap_outer_R.stl
330.0 x 1.20 x 43.4
