Normansrule/skyforge-v18-falcon/cad/v19/v19g_gyr_crest/stl/NEW_crest_L1.stl

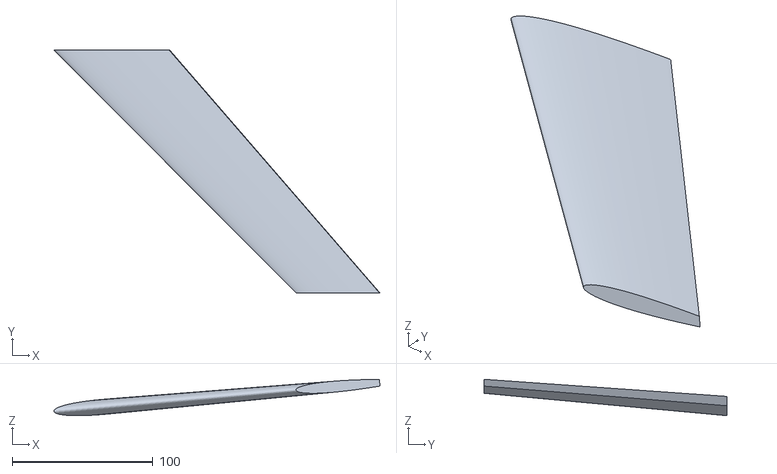
[picture p60: CAD file, 2026-10-06]
cad/v19/v19g_gyr_crest/stl/NEW_crest_L1.stl
231.8 x 172.7 x 25.9
