Normansrule/skyforge-v18-falcon/cad/v19/v19s_stoop_crest/stl/NEW_boom_hanger_front_R.stl

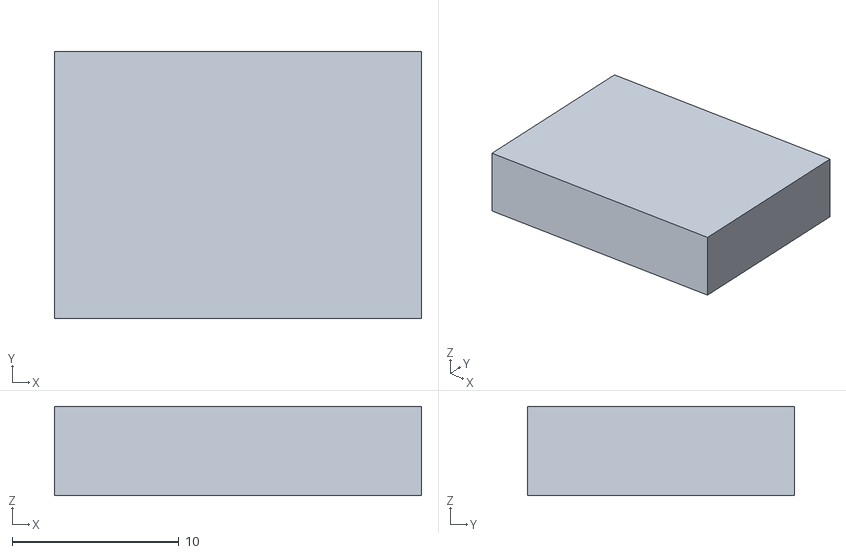
[picture p61: CAD file, 2026-10-06]
cad/v19/v19s_stoop_crest/stl/NEW_boom_hanger_front_R.stl
22.0 x 16.0 x 5.36
