Normansrule/skyforge-v18-falcon/cad/v19/v19w_four_in_wings/stl/NEW_CF_rotor_boom_R_10x10x245.stl

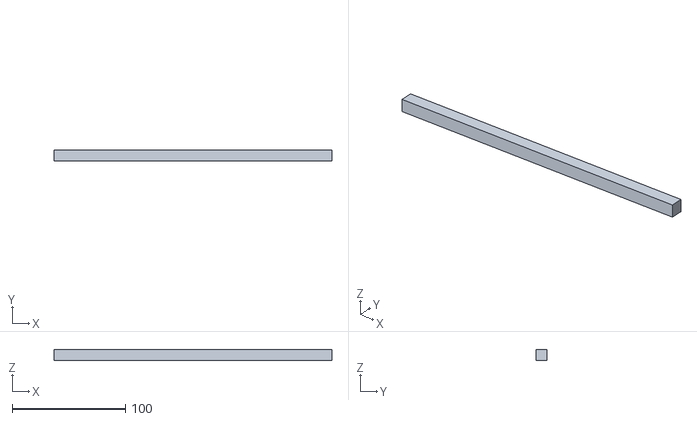
[picture p62: CAD file, 2026-10-04]
cad/v19/v19w_four_in_wings/stl/NEW_CF_rotor_boom_R_10x10x245.stl
245.0 x 10.0 x 10.0
