Normansrule/skyforge-v18-falcon/cad/interface/out/step/SF_nose_steer_collar.step

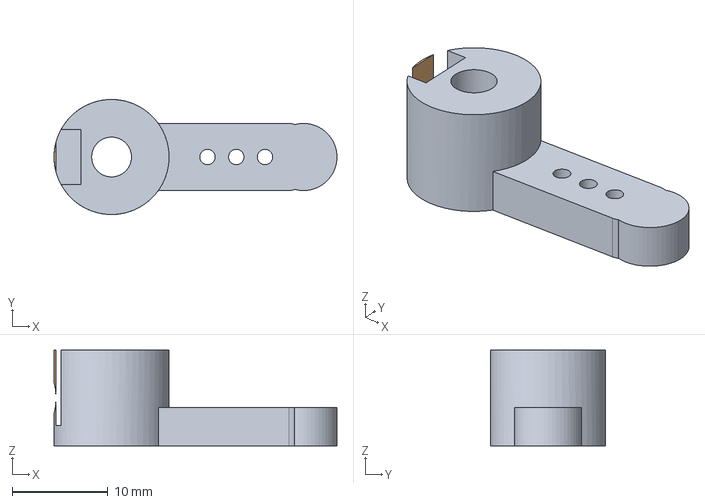
[picture p63: CAD file, 2026-10-02]
cad/interface/out/step/SF_nose_steer_collar.step
29.5 x 12.0 x 10.0 mm
