Normansrule/skyforge-v18-falcon/cad/v19/v19s_stoop_crest/stl/NEW_crest_R1.stl

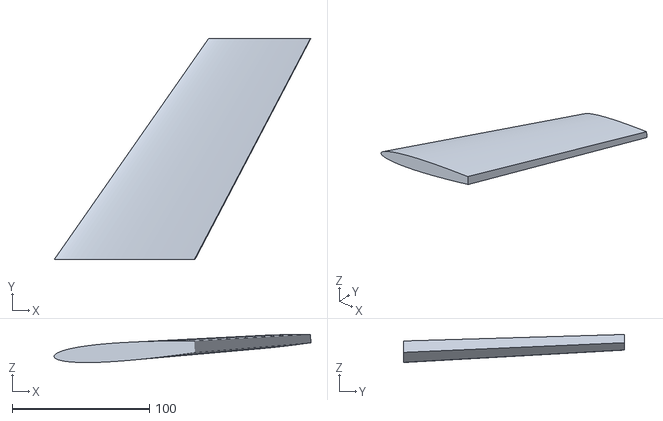
[picture p64: CAD file, 2026-10-06]
cad/v19/v19s_stoop_crest/stl/NEW_crest_R1.stl
187.4 x 161.5 x 20.5
