Normansrule/skyforge-v18-falcon/cad/v19/v19w_four_in_wings/stl/NEW_CF_tail_spar_R_6x4x350.stl

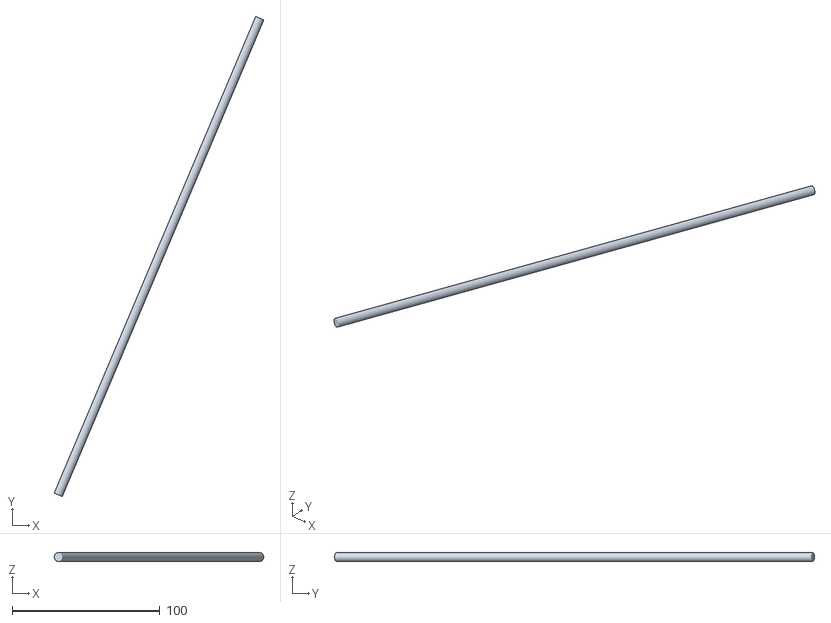
[picture p65: CAD file, 2026-10-04]
cad/v19/v19w_four_in_wings/stl/NEW_CF_tail_spar_R_6x4x350.stl
141.9 x 324.9 x 6.00
