Normansrule/skyforge-v18-falcon/cad/v19/v19f_swift_stoop/stl/NEW_CF_crest_spar_L_6x4x388.stl

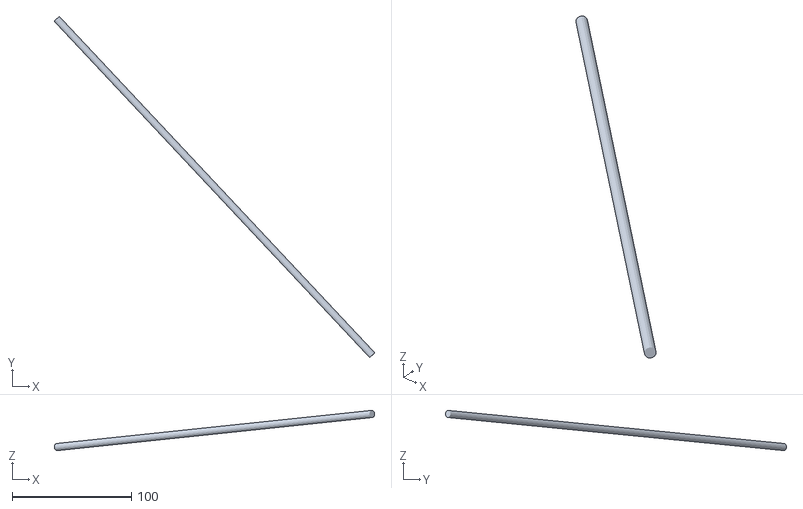
[picture p66: CAD file, 2026-10-06]
cad/v19/v19f_swift_stoop/stl/NEW_CF_crest_spar_L_6x4x388.stl
268.8 x 286.0 x 33.8
