Normansrule/skyforge-v18-falcon/cad/v19/v19g_gyr_crest/stl/NEW_crest_L2.stl

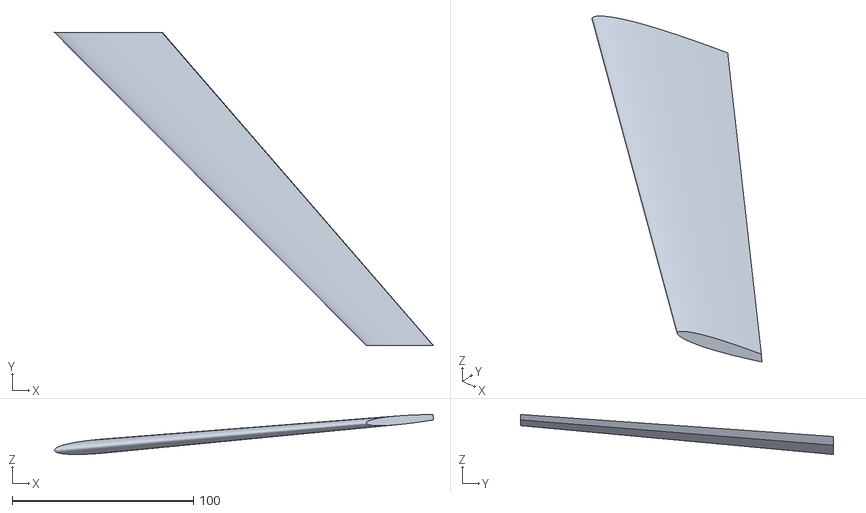
[picture p67: CAD file, 2026-10-06]
cad/v19/v19g_gyr_crest/stl/NEW_crest_L2.stl
209.4 x 173.0 x 22.1
