Normansrule/skyforge-v18-falcon/cad/v19/v19b_falcon_tail/stl/NEW_well_fill_R.stl

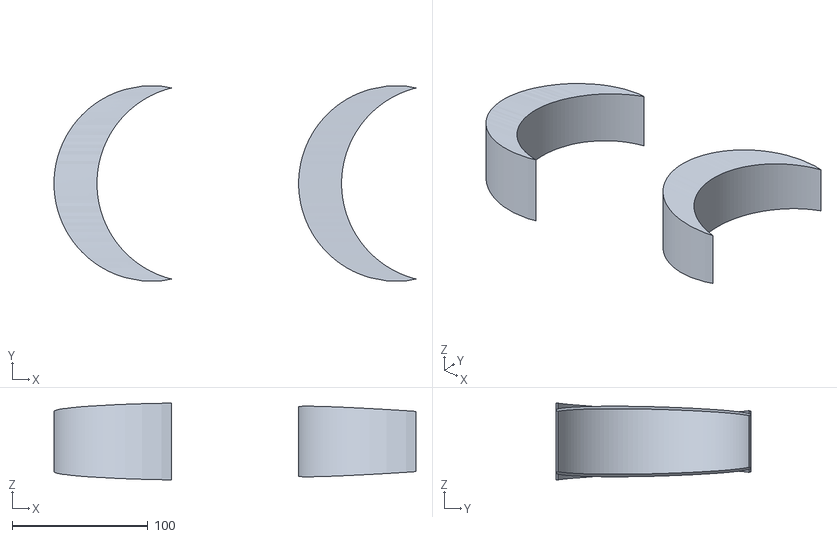
[picture p68: CAD file, 2026-10-04]
cad/v19/v19b_falcon_tail/stl/NEW_well_fill_R.stl
266.4 x 143.3 x 56.5
