Normansrule/skyforge-v18-falcon/cad/v19/v19c_forward_rotors/stl/WLB_hollow_wing__V19.stl

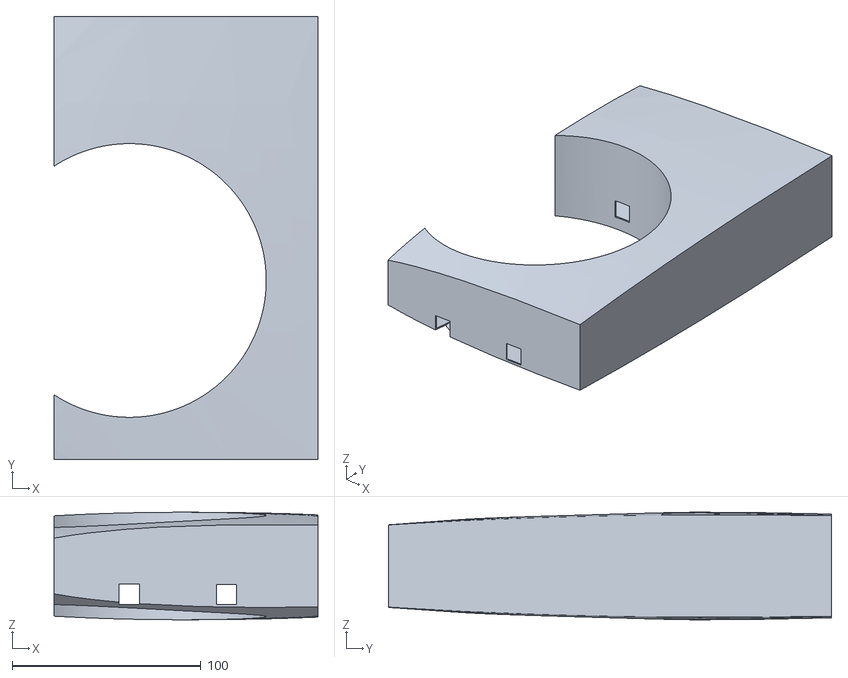
[picture p69: CAD file, 2026-10-02]
cad/v19/v19c_forward_rotors/stl/WLB_hollow_wing__V19.stl
139.7 x 234.7 x 57.0
