Normansrule/skyforge-v18-falcon/cad/v19/v19f_swift_stoop/stl/NEW_crest_elevator_R1.stl

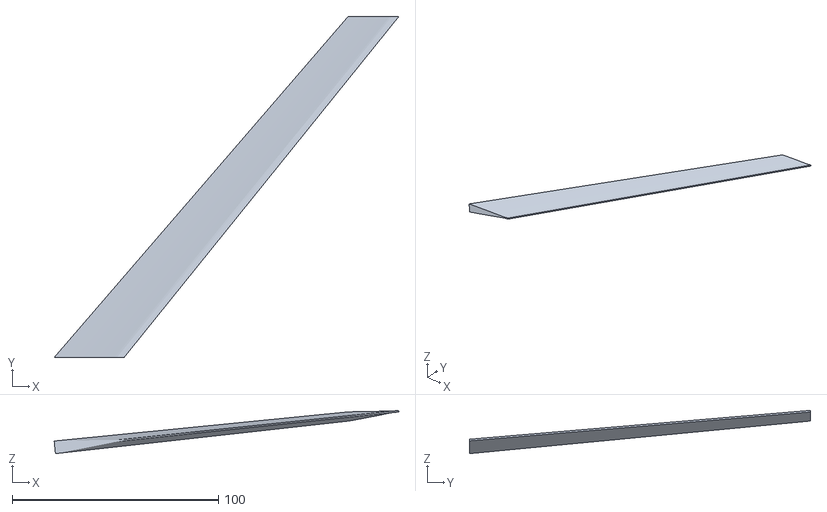
[picture p70: CAD file, 2026-10-06]
cad/v19/v19f_swift_stoop/stl/NEW_crest_elevator_R1.stl
167.1 x 165.3 x 21.0
