Normansrule/skyforge-v18-falcon/cad/v19/v19g_gyr_crest/stl/NEW_crest_elevator_R2.stl

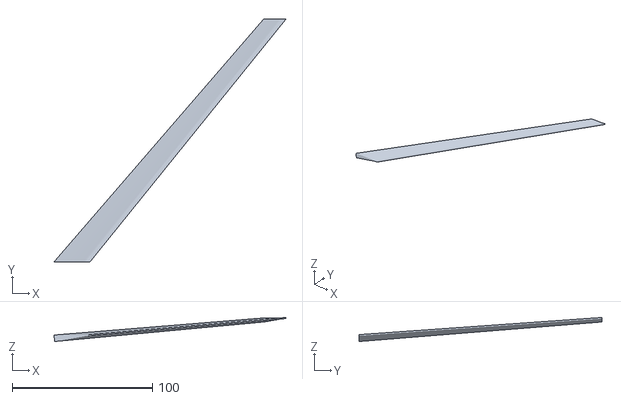
[picture p71: CAD file, 2026-10-06]
cad/v19/v19g_gyr_crest/stl/NEW_crest_elevator_R2.stl
165.3 x 173.0 x 17.2
