Normansrule/skyforge-v18-falcon/cad/v19/v19r_boom_rotors/stl/NEW_front_well_cap_lower_R.stl

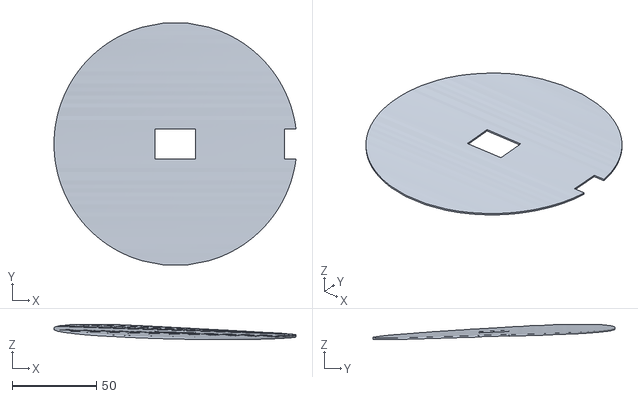
[picture p72: CAD file, 2026-10-02]
cad/v19/v19r_boom_rotors/stl/NEW_front_well_cap_lower_R.stl
143.4 x 143.3 x 9.05
