Normansrule/skyforge-v18-falcon/cad/v19/v19s_stoop_crest/stl/NEW_CF_crest_spar_R_6x4x325.stl

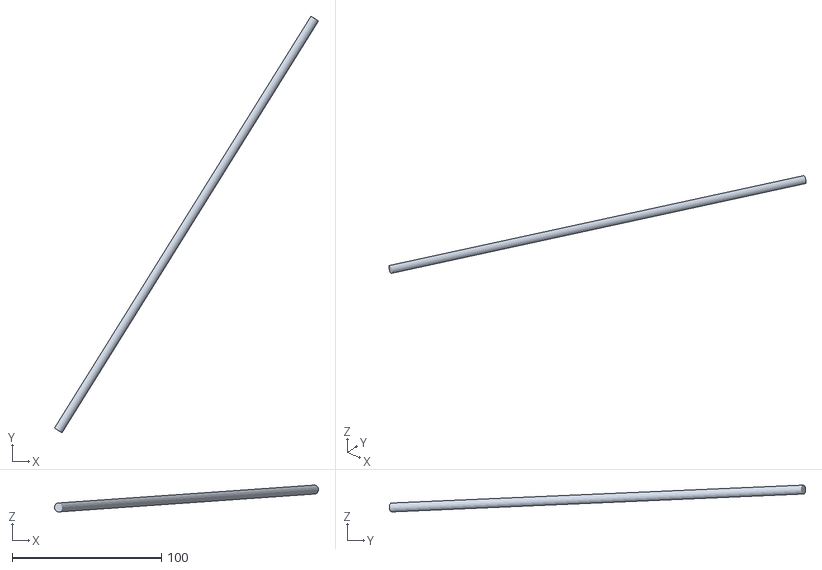
[picture p73: CAD file, 2026-10-06]
cad/v19/v19s_stoop_crest/stl/NEW_CF_crest_spar_R_6x4x325.stl
176.6 x 278.6 x 18.0
