Normansrule/skyforge-v18-falcon/cad/v19/v19w_four_in_wings/stl/WLC_hollow_wing__V19.stl

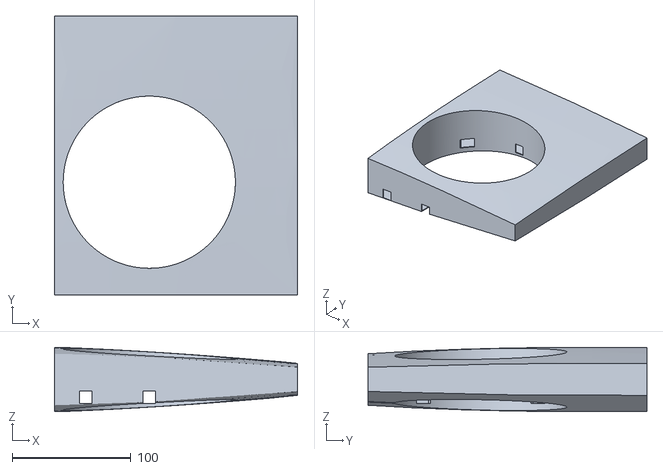
[picture p74: CAD file, 2026-10-04]
cad/v19/v19w_four_in_wings/stl/WLC_hollow_wing__V19.stl
204.7 x 234.7 x 54.2
