Normansrule/skyforge-v18-falcon/cad/v19/v19c_forward_rotors/stl/NEW_front_well_cap_upper_R.stl

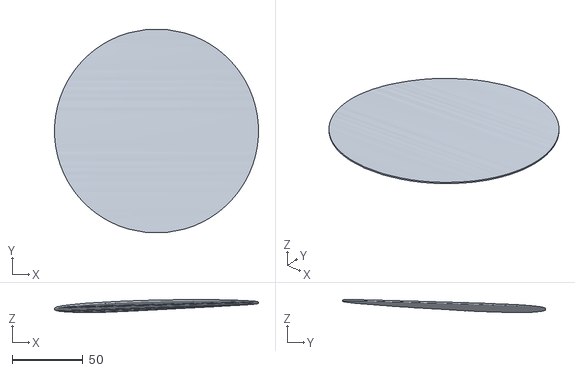
[picture p75: CAD file, 2026-10-02]
cad/v19/v19c_forward_rotors/stl/NEW_front_well_cap_upper_R.stl
144.0 x 143.3 x 9.07
