Normansrule/skyforge-v18-falcon/cad/v19/v19f_swift_stoop/stl/WRD_hollow_wing__V19.stl

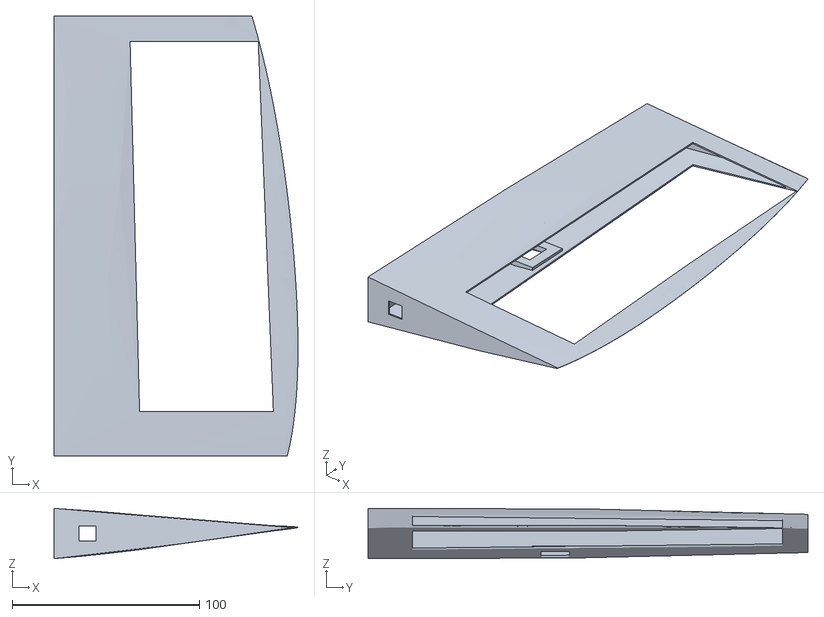
[picture p76: CAD file, 2026-10-06]
cad/v19/v19f_swift_stoop/stl/WRD_hollow_wing__V19.stl
130.2 x 234.7 x 26.8
