Normansrule/skyforge-v18-falcon/cad/v19/v19r_boom_rotors/stl/WRE1_falcon_wing__V19.stl

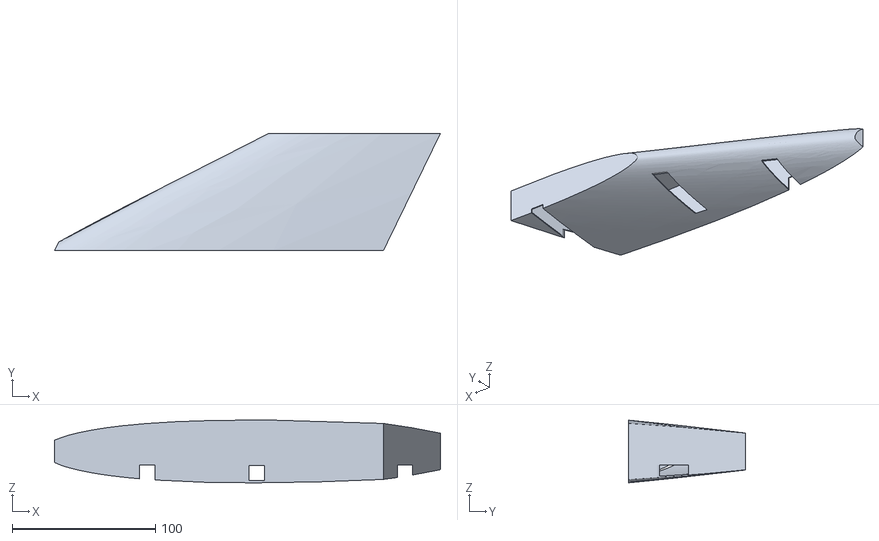
[picture p77: CAD file, 2026-10-02]
cad/v19/v19r_boom_rotors/stl/WRE1_falcon_wing__V19.stl
269.6 x 82.0 x 43.8
