Normansrule/skyforge-v18-falcon/cad/v19/v19w_four_in_wings/stl/NEW_tail_stab_R1.stl

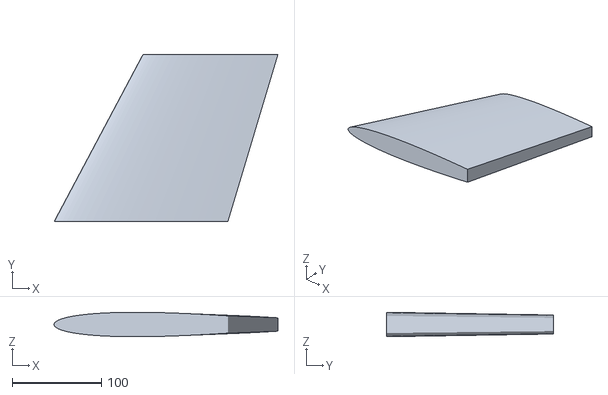
[picture p78: CAD file, 2026-10-04]
cad/v19/v19w_four_in_wings/stl/NEW_tail_stab_R1.stl
251.5 x 188.0 x 27.4
