Normansrule/skyforge-v18-falcon/cad/v19/v19f_swift_stoop/stl/NEW_crest_R2.stl

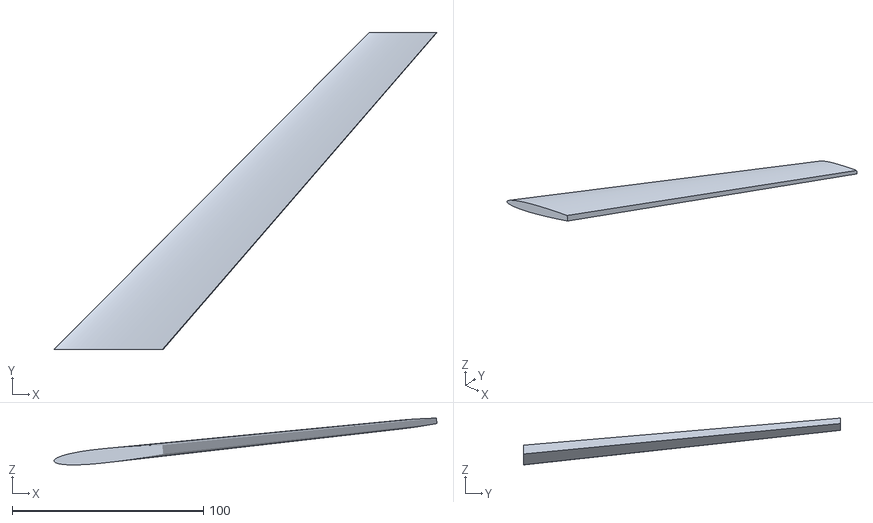
[picture p79: CAD file, 2026-10-06]
cad/v19/v19f_swift_stoop/stl/NEW_crest_R2.stl
200.1 x 165.6 x 24.5
