Normansrule/skyforge-v18-falcon/cad/v19/v19r_boom_rotors/stl/NEW_CF_tail_spar_R_6x4x185.stl

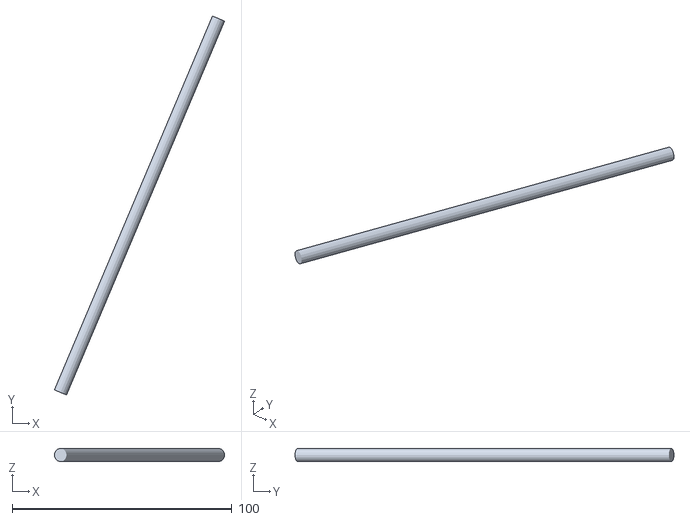
[picture p80: CAD file, 2026-10-02]
cad/v19/v19r_boom_rotors/stl/NEW_CF_tail_spar_R_6x4x185.stl
77.4 x 172.3 x 6.00
