Normansrule/skyforge-v18-falcon/cad/v19/v19s_stoop_crest/stl/FIN_L__V19.stl

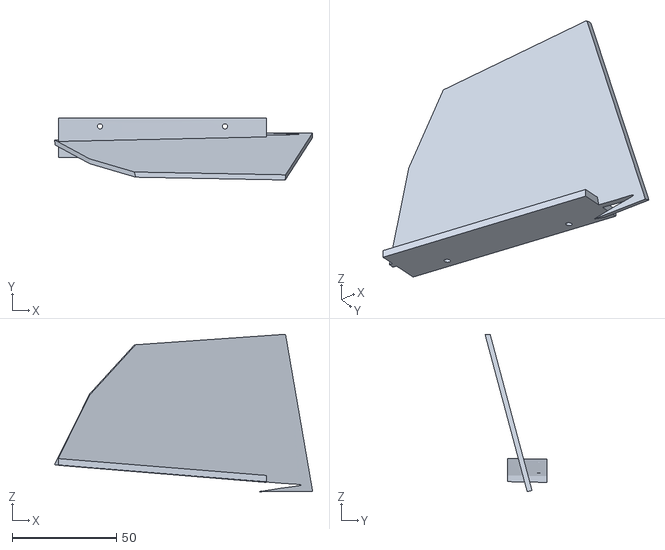
[picture p81: CAD file, 2026-10-06]
cad/v19/v19s_stoop_crest/stl/FIN_L__V19.stl
123.9 x 29.7 x 75.6
