Normansrule/skyforge-v18-falcon/cad/v19/v19r_boom_rotors/stl/NEW_front_motor_pod_R.stl

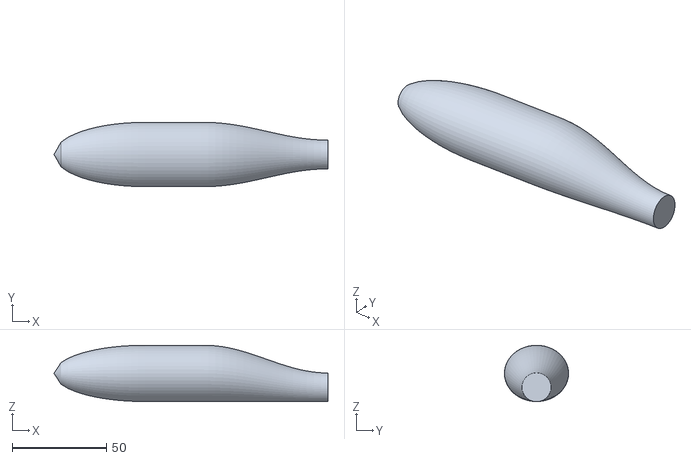
[picture p82: CAD file, 2026-10-02]
cad/v19/v19r_boom_rotors/stl/NEW_front_motor_pod_R.stl
145.0 x 34.0 x 29.9
