Normansrule/skyforge-v18-falcon/cad/v19/v19s_stoop_crest/stl/NEW_crest_L2.stl

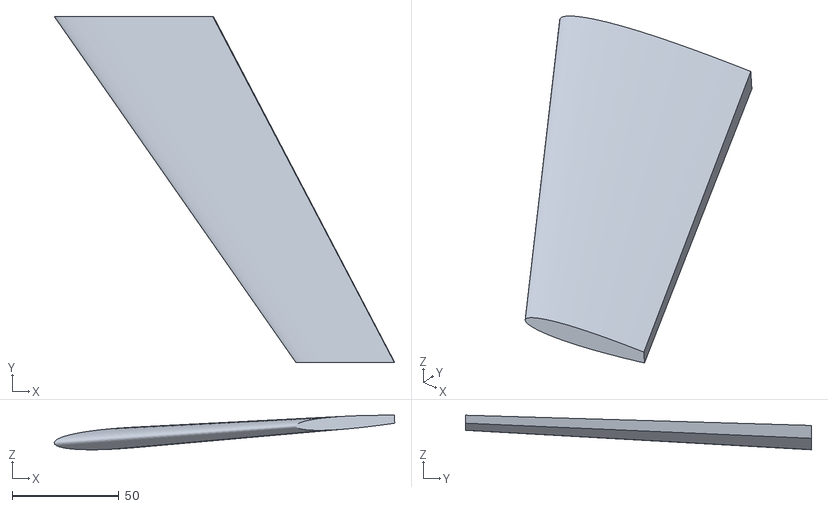
[picture p83: CAD file, 2026-10-06]
cad/v19/v19s_stoop_crest/stl/NEW_crest_L2.stl
159.3 x 161.8 x 16.2
