Normansrule/skyforge-v18-falcon/cad/v19/v19b_falcon_tail/stl/NEW_tail_fin_R.stl

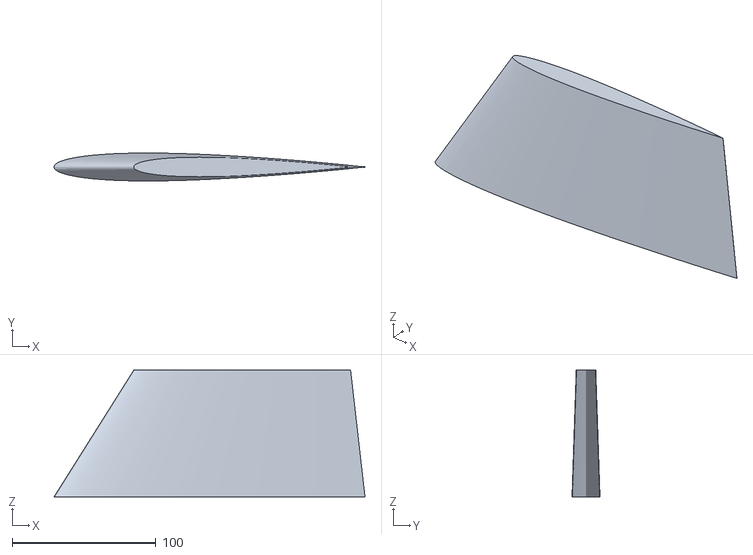
[picture p84: CAD file, 2026-10-02]
cad/v19/v19b_falcon_tail/stl/NEW_tail_fin_R.stl
216.1 x 19.4 x 88.0
