Normansrule/skyforge-v18-falcon/cad/v19/v19c_forward_rotors/stl/NEW_front_well_cap_lower_L.stl

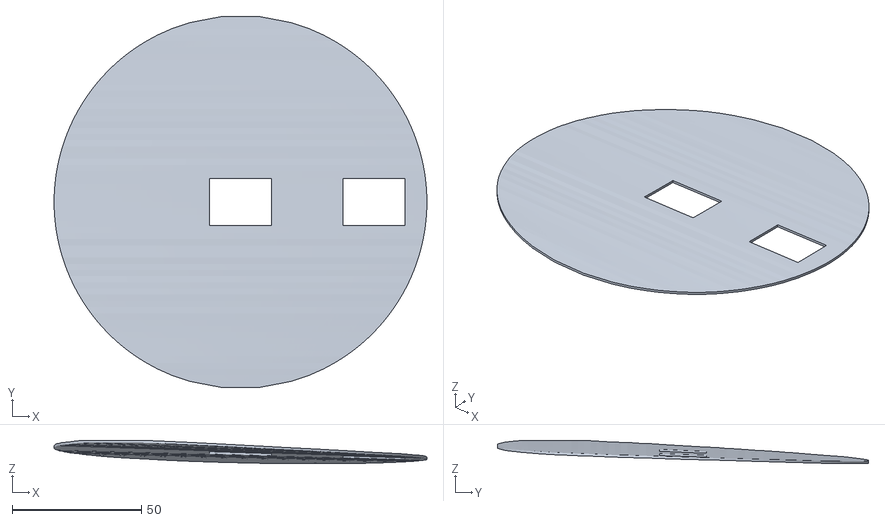
[picture p85: CAD file, 2026-10-02]
cad/v19/v19c_forward_rotors/stl/NEW_front_well_cap_lower_L.stl
144.0 x 143.3 x 9.05
