Normansrule/skyforge-v18-falcon/cad/v19/v19f_swift_stoop/stl/FIN_L__V19.stl

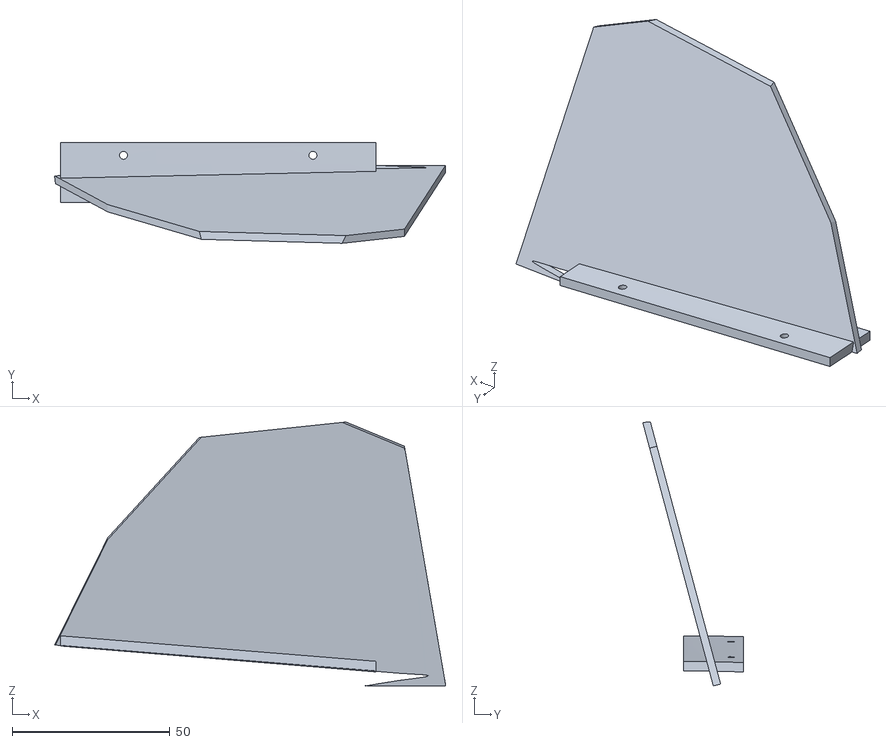
[picture p86: CAD file, 2026-10-06]
cad/v19/v19f_swift_stoop/stl/FIN_L__V19.stl
123.9 x 31.9 x 83.6
