Normansrule/skyforge-v18-falcon/cad/v19/v19s_stoop_crest/stl/NEW_crest_elevator_L2.stl

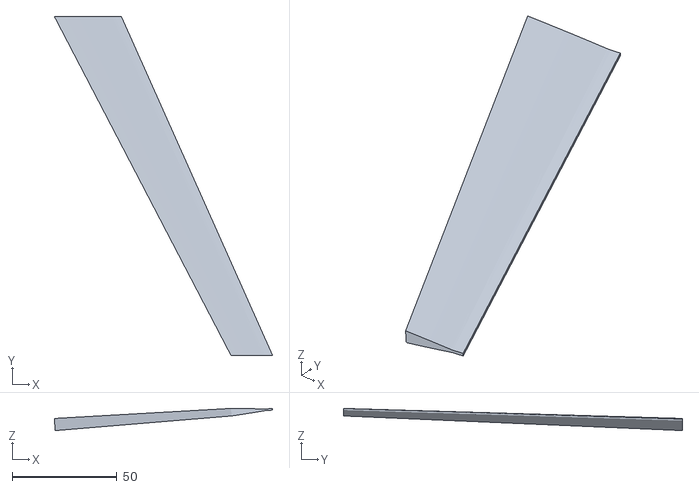
[picture p87: CAD file, 2026-10-06]
cad/v19/v19s_stoop_crest/stl/NEW_crest_elevator_L2.stl
104.2 x 161.8 x 10.6
