Normansrule/skyforge-v18-falcon/cad/v19/v19w_four_in_wings/stl/NEW_tail_elevator_R2.stl

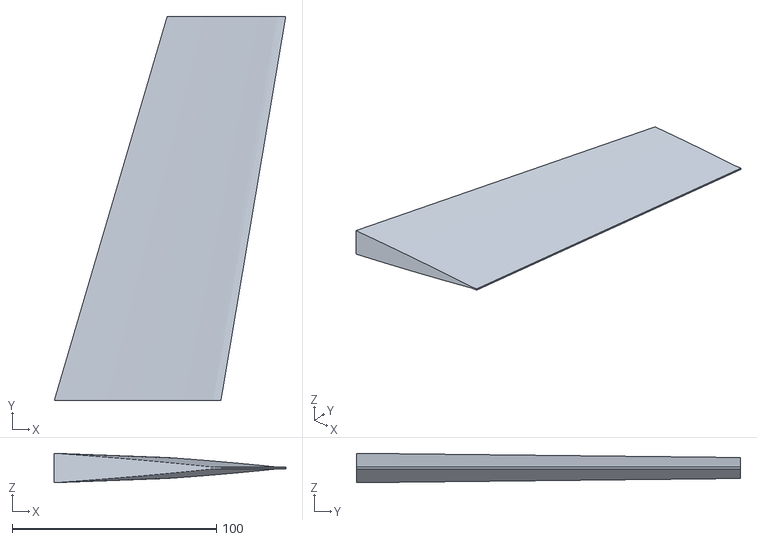
[picture p88: CAD file, 2026-10-04]
cad/v19/v19w_four_in_wings/stl/NEW_tail_elevator_R2.stl
113.3 x 188.0 x 14.4
