Normansrule/skyforge-v18-falcon/cad/v19/v19c_forward_rotors/stl/NEW_F5_root_fairing_R.stl

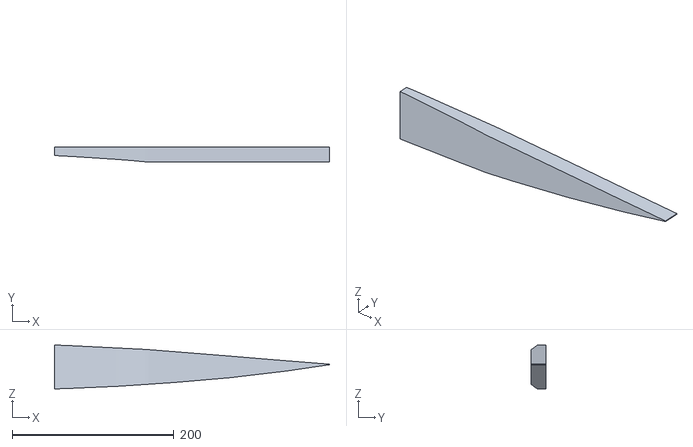
[picture p89: CAD file, 2026-10-02]
cad/v19/v19c_forward_rotors/stl/NEW_F5_root_fairing_R.stl
340.0 x 18.5 x 54.1
