Normansrule/skyforge-v18-falcon/cad/v19/v19f_swift_stoop/stl/NEW_wrist_cap_inner_R.stl

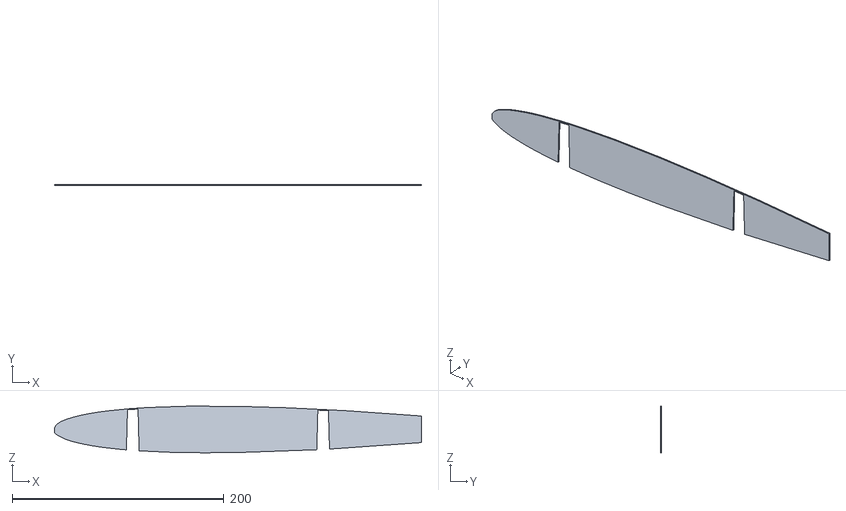
[picture p90: CAD file, 2026-10-06]
cad/v19/v19f_swift_stoop/stl/NEW_wrist_cap_inner_R.stl
347.0 x 1.20 x 44.1
