Normansrule/skyforge-v18-falcon/cad/v19/v19r_boom_rotors/stl/NEW_F5_root_fairing_R.stl

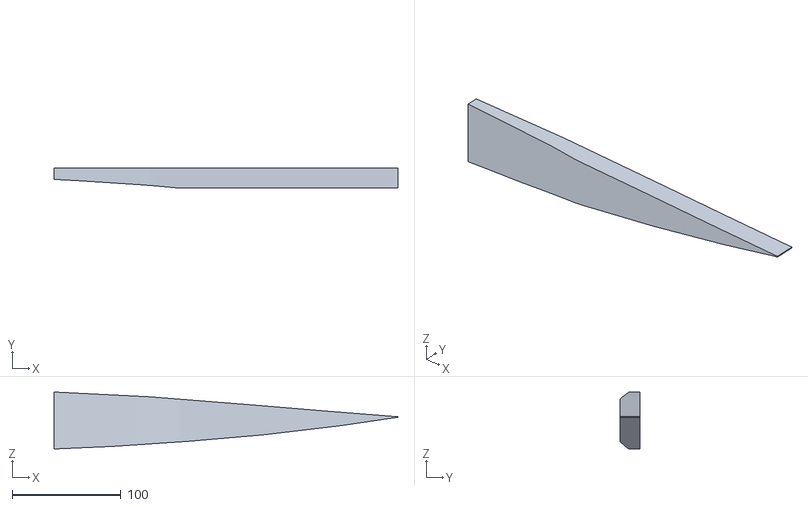
[picture p91: CAD file, 2026-10-02]
cad/v19/v19r_boom_rotors/stl/NEW_F5_root_fairing_R.stl
316.0 x 18.5 x 52.3
