Normansrule/skyforge-v18-falcon/cad/v19/v19s_stoop_crest/stl/NEW_CF_wrist_spar_R_10x10x219.stl

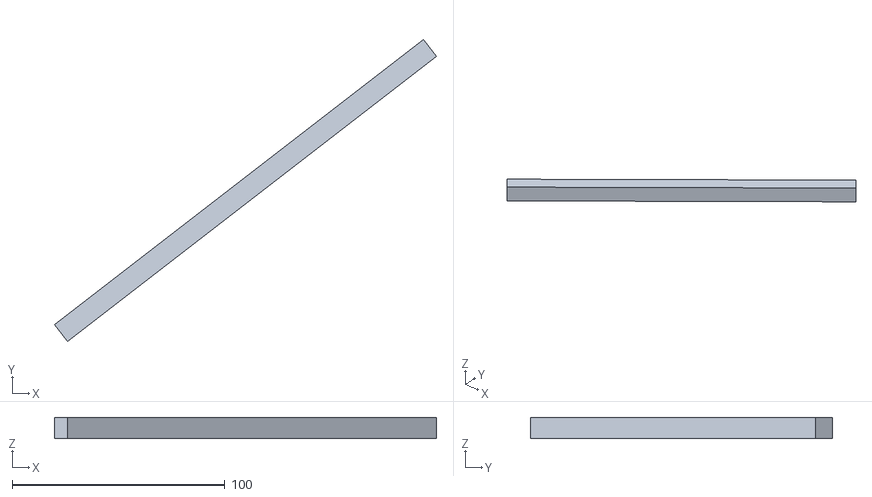
[picture p92: CAD file, 2026-10-06]
cad/v19/v19s_stoop_crest/stl/NEW_CF_wrist_spar_R_10x10x219.stl
179.5 x 141.9 x 10.0
