Normansrule/skyforge-v18-falcon/cad/v19/v19w_four_in_wings/stl/NEW_tail_elevator_R1.stl

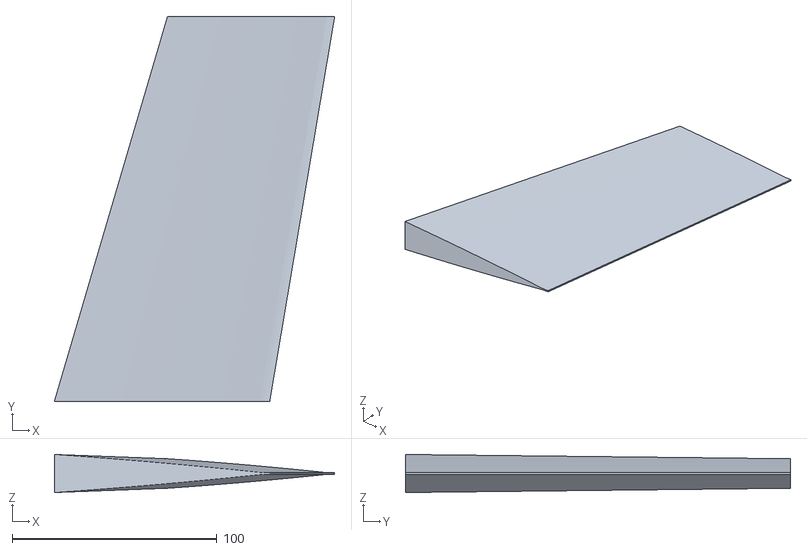
[picture p93: CAD file, 2026-10-04]
cad/v19/v19w_four_in_wings/stl/NEW_tail_elevator_R1.stl
136.9 x 188.0 x 18.6
