Normansrule/skyforge-v18-falcon/cad/v19/v19b_falcon_tail/stl/NEW_CF_tail_boom_L_8x8x490.stl

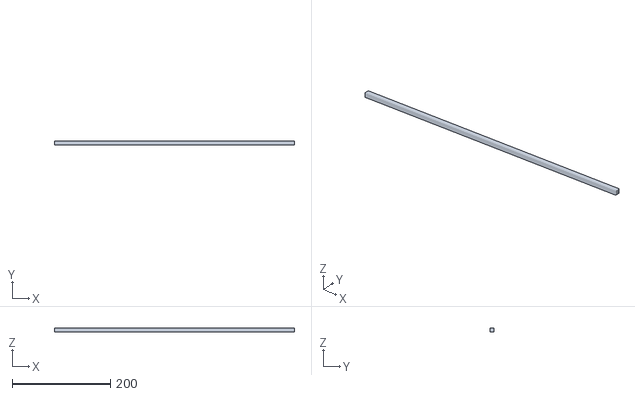
[picture p94: CAD file, 2026-10-02]
cad/v19/v19b_falcon_tail/stl/NEW_CF_tail_boom_L_8x8x490.stl
489.8 x 8.00 x 8.00
