Normansrule/skyforge-v18-falcon/cad/v19/v19r_boom_rotors/stl/NEW_boom_hanger_front_R.stl

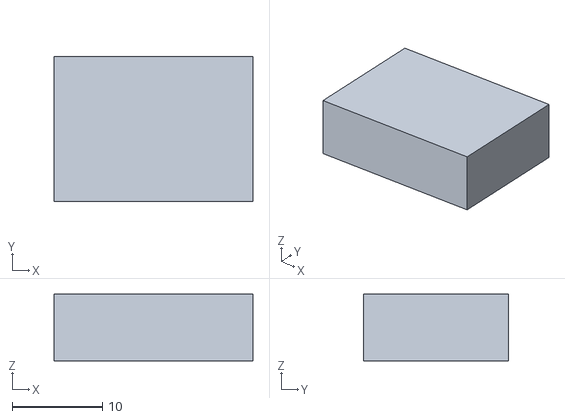
[picture p95: CAD file, 2026-10-02]
cad/v19/v19r_boom_rotors/stl/NEW_boom_hanger_front_R.stl
22.0 x 16.0 x 7.36
