Normansrule/skyforge-v18-falcon/cad/v19/v19s_stoop_crest/stl/NEW_wrist_cap_inner_L.stl

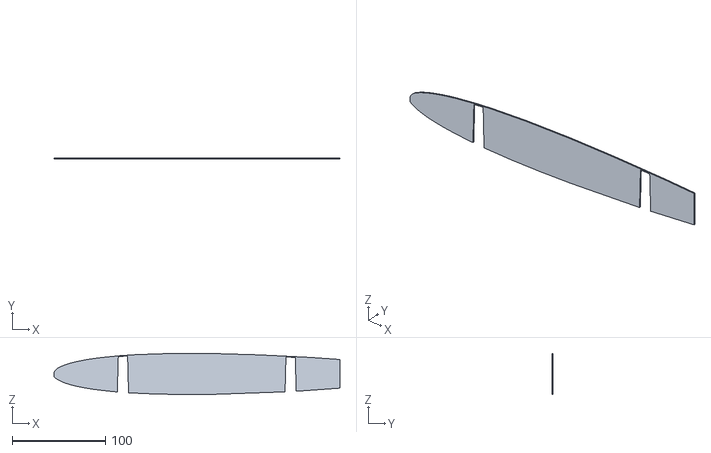
[picture p96: CAD file, 2026-10-06]
cad/v19/v19s_stoop_crest/stl/NEW_wrist_cap_inner_L.stl
307.0 x 1.20 x 44.1
