Normansrule/skyforge-v18-falcon/cad/v19/v19b_falcon_tail/stl/NEW_CF_tail_spar_L_6x4x320.stl

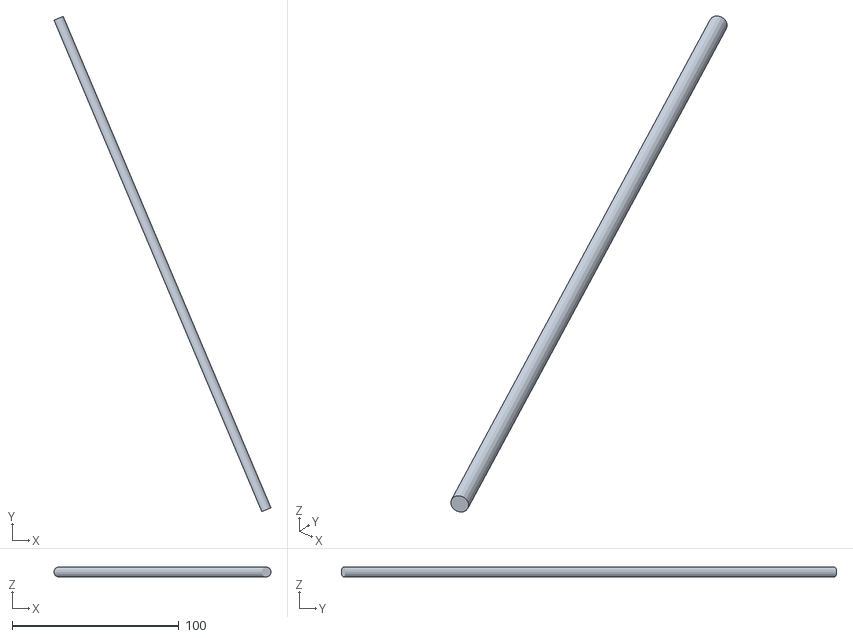
[picture p97: CAD file, 2026-10-02]
cad/v19/v19b_falcon_tail/stl/NEW_CF_tail_spar_L_6x4x320.stl
130.0 x 296.8 x 6.00
