Normansrule/skyforge-v18-falcon/cad/v19/v19g_gyr_crest/stl/NEW_wrist_cap_outer_L.stl

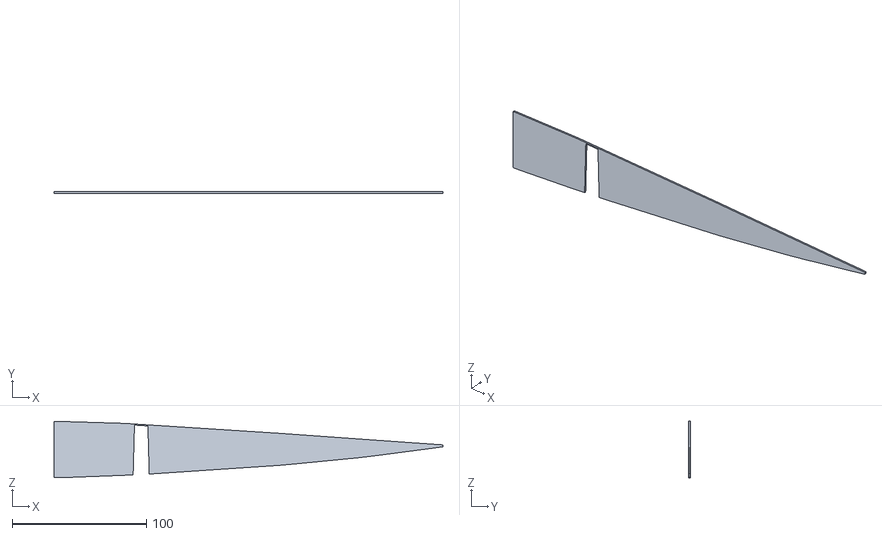
[picture p98: CAD file, 2026-10-06]
cad/v19/v19g_gyr_crest/stl/NEW_wrist_cap_outer_L.stl
290.0 x 1.20 x 42.1
