Normansrule/skyforge-v18-falcon/cad/v19/v19g_gyr_crest/stl/NEW_F5_root_fairing_R.stl

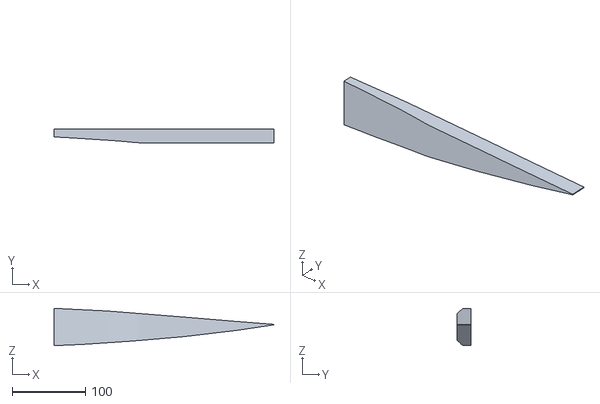
[picture p99: CAD file, 2026-10-06]
cad/v19/v19g_gyr_crest/stl/NEW_F5_root_fairing_R.stl
300.0 x 18.5 x 50.9
