Normansrule/skyforge-v18-falcon/cad/v19/v19w_four_in_wings/stl/NEW_tail_fin_L.stl

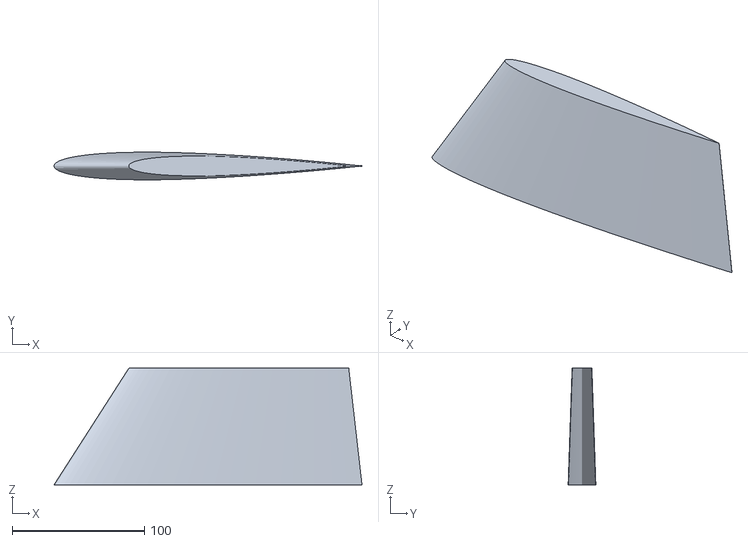
[picture p100: CAD file, 2026-10-04]
cad/v19/v19w_four_in_wings/stl/NEW_tail_fin_L.stl
232.6 x 20.9 x 88.0
