Normansrule/skyforge-v18-falcon/cad/v19/v19r_boom_rotors/stl/NEW_CF_rotor_boom_R_10x10x456.stl

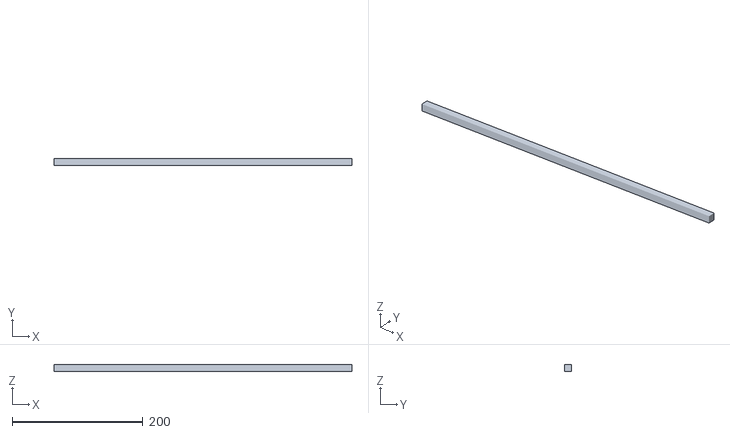
[picture p101: CAD file, 2026-10-02]
cad/v19/v19r_boom_rotors/stl/NEW_CF_rotor_boom_R_10x10x456.stl
455.5 x 10.0 x 10.0
