Normansrule/skyforge-v18-falcon/cad/v19/v19r_boom_rotors/stl/NEW_G10_nose_battery_floor.stl

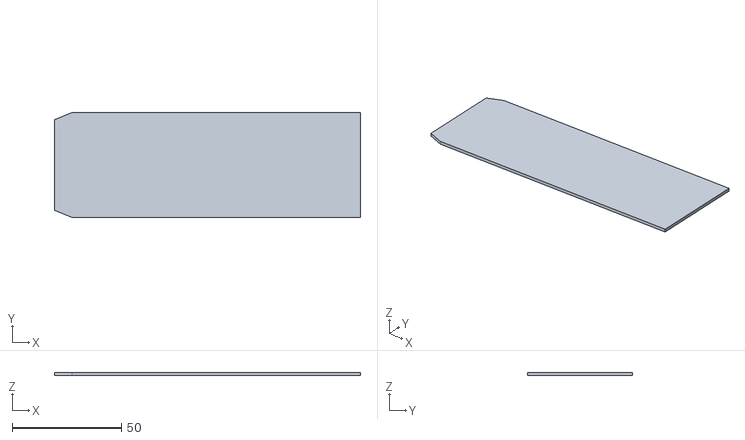
[picture p102: CAD file, 2026-10-02]
cad/v19/v19r_boom_rotors/stl/NEW_G10_nose_battery_floor.stl
140.0 x 48.0 x 1.50
