Normansrule/skyforge-v18-falcon/cad/v19/v19r_boom_rotors/stl/NEW_nose_battery_rails.stl

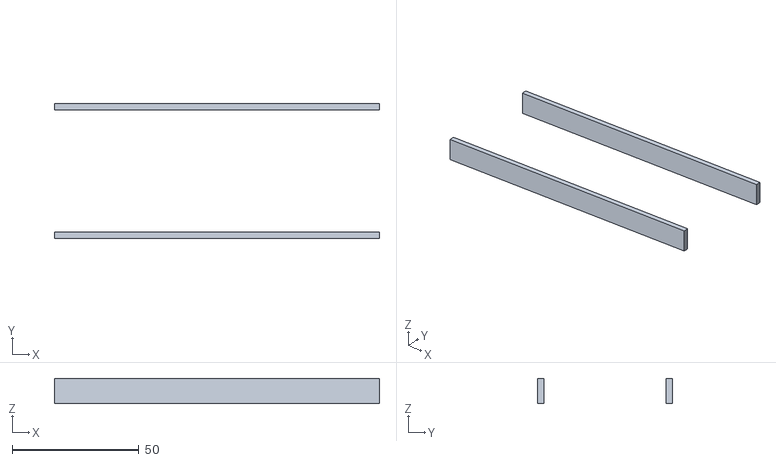
[picture p103: CAD file, 2026-10-02]
cad/v19/v19r_boom_rotors/stl/NEW_nose_battery_rails.stl
128.0 x 53.0 x 10.0
