Normansrule/skyforge-v18-falcon/(list of files, cad)

Other CAD files:
cad/v19/v19r_boom_rotors/stl/NEW_tail_stab_R.stl
cad/v19/v19a_long_nose/stl/NEW_well_fill_L.stl
cad/v19/v19c_forward_rotors/stl/NEW_CF_rotor_boom_R_10x10x523.stl
cad/v19/v19g_gyr_crest/stl/NEW_CF_crest_spar_L_6x4x405.stl
cad/v19/v19r_boom_rotors/stl/NEW_tail_elevator_R.stl
cad/v19/v19a_long_nose/stl/NEW_F5_root_fairing_L.stl
cad/v19/v19b_falcon_tail/stl/NEW_tail_elevator_L1.stl
cad/v19/v19c_forward_rotors/stl/NEW_front_motor_pod_L.stl
cad/v19/v19f_swift_stoop/stl/NEW_CF_wrist_spar_L_10x10x254.stl
cad/v19/v19g_gyr_crest/stl/NEW_crest_R1.stl
cad/v19/v19r_boom_rotors/stl/F3_hollow_body__V19.stl
cad/interface/out/step/SF_XC_drill_template_PLA.step
cad/v19/v19a_long_nose/stl/NEW_leading_edge_glove_R.stl
cad/v19/v19b_falcon_tail/stl/NEW_tail_stab_L2.stl
cad/v19/v19c_forward_rotors/stl/NEW_rear_motor_riser_L.stl
cad/v19/v19r_boom_rotors/stl/NEW_rear_motor_riser_R.stl
cad/v19/v19s_stoop_crest/stl/NEW_CF_rotor_boom_R_10x10x245.stl
cad/v19/v19w_four_in_wings/stl/NEW_boom_hanger_front_L.stl
cad/interface/out/step/SF_XC_belly_strap_G10_2p0.step
cad/v19/v19b_falcon_tail/stl/NEW_tail_elevator_L2.stl
cad/v19/v19g_gyr_crest/stl/NEW_crest_elevator_R1.stl
cad/v19/v19s_stoop_crest/stl/NEW_CF_rotor_boom_L_10x10x245.stl
cad/v19/v19b_falcon_tail/stl/NEW_tail_stab_R1.stl
cad/v19/v19c_forward_rotors/stl/WRE1_falcon_wing__V19.stl
cad/v19/v19g_gyr_crest/stl/NEW_crest_elevator_L2.stl
cad/v19/v19w_four_in_wings/stl/WLE2_falcon_wing__V19.stl
cad/v19/v19b_falcon_tail/stl/NEW_well_fill_L.stl
cad/v19/v19c_forward_rotors/stl/NEW_rear_motor_riser_R.stl
cad/v19/v19f_swift_stoop/stl/WLD_hollow_wing__V19.stl
cad/v19/v19g_gyr_crest/stl/NEW_crest_R2.stl
cad/v19/v19w_four_in_wings/stl/NEW_boom_hanger_front_R.stl
cad/v19/v19g_gyr_crest/stl/NEW_boom_hanger_front_R.stl
cad/v19/v19r_boom_rotors/stl/NEW_front_well_cap_lower_L.stl
cad/v19/v19b_falcon_tail/stl/NEW_tail_fin_L.stl
cad/v19/v19g_gyr_crest/stl/NEW_CF_rotor_boom_L_10x10x245.stl
cad/v19/v19c_forward_rotors/stl/WLE1_falcon_wing__V19.stl
cad/v19/v19f_swift_stoop/stl/WLE2_falcon_wing__V19.stl
cad/v19/v19g_gyr_crest/stl/NEW_CF_wrist_spar_R_10x10x219.stl
cad/v19/v19w_four_in_wings/stl/NEW_tail_elevator_L1.stl
cad/v19/v19c_forward_rotors/stl/NEW_F5_root_fairing_L.stl
cad/v19/v19f_swift_stoop/stl/WRE1_falcon_wing__V19.stl
cad/v19/v19r_boom_rotors/stl/NEW_CF_tail_spar_L_6x4x185.stl
cad/v19/v19s_stoop_crest/stl/F3_hollow_body__V19.stl
cad/v19/v19w_four_in_wings/stl/WRE1_falcon_wing__V19.stl
cad/v19/v19b_falcon_tail/stl/NEW_CF_tail_spar_R_6x4x320.stl
cad/v19/v19c_forward_rotors/stl/NEW_boom_hanger_front_R.stl
cad/v19/v19f_swift_stoop/stl/NEW_crest_elevator_L2.stl
cad/v19/v19r_boom_rotors/stl/NEW_boom_hanger_front_L.stl
cad/v19/v19s_stoop_crest/stl/NEW_rear_motor_riser_L.stl
cad/v19/v19b_falcon_tail/stl/NEW_CF_tail_boom_R_8x8x490.stl
cad/v19/v19c_forward_rotors/stl/NEW_front_well_cap_upper_L.stl
cad/v19/v19f_swift_stoop/stl/NEW_crest_L2.stl
cad/v19/v19g_gyr_crest/stl/NEW_CF_rotor_boom_R_10x10x245.stl
cad/v19/v19s_stoop_crest/stl/WLE1_falcon_wing__V19.stl
cad/v19/v19w_four_in_wings/stl/NEW_tail_elevator_L2.stl
cad/v19/v19c_forward_rotors/stl/WRB_hollow_wing__V19.stl
cad/v19/v19f_swift_stoop/stl/WLC_hollow_wing__V19.stl
cad/v19/v19g_gyr_crest/stl/NEW_F5_root_fairing_L.stl
cad/v19/v19r_boom_rotors/stl/WLB_hollow_wing__V19.stl
cad/v19/v19s_stoop_crest/stl/NEW_wrist_cap_outer_R.stl
cad/v19/v19w_four_in_wings/stl/NEW_tail_stab_R2.stl
cad/v19/v19c_forward_rotors/stl/NEW_boom_hanger_front_L.stl
cad/v19/v19f_swift_stoop/stl/NEW_CF_crest_spar_R_6x4x388.stl
cad/v19/v19g_gyr_crest/stl/NEW_CF_wrist_spar_L_10x10x219.stl
cad/v19/v19s_stoop_crest/stl/NEW_crest_elevator_R2.stl
cad/v19/v19w_four_in_wings/stl/NEW_tail_fin_R.stl
cad/v19/v19c_forward_rotors/stl/NEW_front_well_cap_lower_R.stl
cad/v19/v19f_swift_stoop/stl/WRE2_falcon_wing__V19.stl
cad/v19/v19g_gyr_crest/stl/NEW_wrist_cap_inner_R.stl
cad/v19/v19s_stoop_crest/stl/WRD_hollow_wing__V19.stl
cad/interface/out/3mf/SF_EDF_ear_bracket_lower.3mf
cad/interface/out/3mf/SF_EDF_ear_bracket_upper.3mf
cad/interface/out/3mf/SF_FC_iso_pad_TPU.3mf
cad/interface/out/3mf/SF_XC_drill_template_PLA.3mf
cad/interface/out/3mf/SF_nose_steer_collar.3mf
cad/interface/out/dxf/SF_XC_belly_strap_G10_2p0.dxf
cad/interface/out/dxf/SF_XC_crossing_clamp_G10_2p0.dxf
cad/interface/out/stl/SF_EDF_ear_bracket_lower.stl
cad/interface/out/stl/SF_EDF_ear_bracket_upper.stl
cad/interface/out/stl/SF_FC_iso_pad_TPU.stl
cad/interface/out/stl/SF_XC_belly_strap_G10_2p0.stl
cad/interface/out/stl/SF_XC_crossing_clamp_G10_2p0.stl
cad/interface/out/stl/SF_XC_drill_template_PLA.stl
cad/interface/out/stl/SF_nose_steer_collar.stl
cad/v18/V18_EQUIPMENT_ASSEMBLY_VIEW_ONLY.3mf
cad/v18/dxf/G10_cassette_A_support_left_t2.0.dxf
cad/v18/dxf/G10_cassette_B_support_left_t2.0.dxf
cad/v18/dxf/G10_main_gear_left_t2.5.dxf
cad/v18/dxf/G10_motor_backing_2_t2.5.dxf
cad/v18/dxf/G10_motor_backing_3_t2.5.dxf
cad/v18/dxf/G10_motor_backing_4_t2.5.dxf
cad/v18/dxf/G10_motor_plate_2_t2.5.dxf
cad/v18/dxf/G10_motor_plate_3_t2.5.dxf
cad/v18/dxf/G10_motor_plate_4_t2.5.dxf
cad/v18/dxf/PURCHASE_OR_CUT_cassette_A_support_strip_t2.0.dxf
cad/v18/dxf/PURCHASE_OR_CUT_cassette_B_support_strip_t2.0.dxf
cad/v18/dxf/PURCHASE_OR_CUT_main_gear_plate_t2.5.dxf
cad/v18/dxf/PURCHASE_OR_CUT_motor_backing_plate_t2.5.dxf
cad/v18/dxf/PURCHASE_OR_CUT_motor_plate_PRINT_TEMPLATE_NOT_FLIGHT_t2.5.dxf
cad/v18/dxf/PURCHASE_OR_CUT_nose_gear_bridge_t2.5.dxf
cad/v19/v19f_swift_stoop/stl/CF_crossrail_450_10x10x820__V19.stl
cad/v19/v19f_swift_stoop/stl/F3_hollow_body__V19.stl
cad/v19/v19f_swift_stoop/stl/NEW_CF_rotor_boom_L_10x10x245.stl
cad/v19/v19f_swift_stoop/stl/NEW_CF_rotor_boom_R_10x10x245.stl
cad/v19/v19f_swift_stoop/stl/NEW_F5_root_fairing_L.stl
cad/v19/v19f_swift_stoop/stl/NEW_boom_hanger_front_L.stl
cad/v19/v19f_swift_stoop/stl/NEW_boom_hanger_front_R.stl
cad/v19/v19f_swift_stoop/stl/NEW_boom_hanger_rear_L.stl
cad/v19/v19f_swift_stoop/stl/NEW_boom_hanger_rear_R.stl
cad/v19/v19f_swift_stoop/stl/NEW_canopy_clear_PETG.stl
cad/v19/v19f_swift_stoop/stl/NEW_canopy_frame.stl
cad/v19/v19f_swift_stoop/stl/NEW_cockpit_camera_seat.stl
cad/v19/v19f_swift_stoop/stl/NEW_crest_L1.stl
cad/v19/v19f_swift_stoop/stl/NEW_crest_R1.stl
cad/v19/v19f_swift_stoop/stl/NEW_crest_elevator_L1.stl
cad/v19/v19f_swift_stoop/stl/NEW_rear_motor_riser_L.stl
cad/v19/v19f_swift_stoop/stl/NEW_rear_motor_riser_R.stl
cad/v19/v19f_swift_stoop/stl/NEW_wrist_cap_inner_L.stl
cad/v19/v19f_swift_stoop/stl/NEW_wrist_cap_outer_L.stl
cad/v19/v19f_swift_stoop/stl/WLB_hollow_wing__V19.stl
cad/v19/v19f_swift_stoop/stl/WLE1_falcon_wing__V19.stl
cad/v19/v19f_swift_stoop/stl/WRB_hollow_wing__V19.stl
cad/v19/v19f_swift_stoop/stl/WRC_hollow_wing__V19.stl
cad/v19/v19g_gyr_crest/stl/NEW_boom_hanger_front_L.stl
cad/v19/v19g_gyr_crest/stl/NEW_boom_hanger_rear_L.stl
cad/v19/v19g_gyr_crest/stl/NEW_boom_hanger_rear_R.stl
cad/v19/v19g_gyr_crest/stl/NEW_canopy_clear_PETG.stl
cad/v19/v19g_gyr_crest/stl/NEW_canopy_frame.stl
cad/v19/v19g_gyr_crest/stl/NEW_cockpit_camera_seat.stl
cad/v19/v19g_gyr_crest/stl/NEW_rear_motor_riser_L.stl
cad/v19/v19g_gyr_crest/stl/NEW_rear_motor_riser_R.stl
cad/v19/v19g_gyr_crest/stl/NEW_wrist_cap_inner_L.stl
cad/v19/v19g_gyr_crest/stl/NEW_wrist_cap_outer_R.stl
cad/v19/v19r_boom_rotors/dxf/NEW_G10_nose_battery_floor.dxf
cad/v19/v19r_boom_rotors/stl/F4_hollow_body__V19.stl
cad/v19/v19r_boom_rotors/stl/NEW_CF_rotor_boom_L_10x10x456.stl
cad/v19/v19r_boom_rotors/stl/NEW_CF_tail_boom_L_8x8x547.stl
cad/v19/v19r_boom_rotors/stl/NEW_CF_tail_boom_R_8x8x547.stl
cad/v19/v19r_boom_rotors/stl/NEW_F5_root_fairing_L.stl
cad/v19/v19r_boom_rotors/stl/NEW_front_motor_pod_L.stl
cad/v19/v19r_boom_rotors/stl/NEW_front_well_cap_upper_L.stl
cad/v19/v19r_boom_rotors/stl/NEW_front_well_cap_upper_R.stl
cad/v19/v19r_boom_rotors/stl/NEW_rear_motor_riser_L.stl
cad/v19/v19r_boom_rotors/stl/NEW_tail_fin_L.stl
cad/v19/v19r_boom_rotors/stl/NEW_tail_fin_R.stl
cad/v19/v19r_boom_rotors/stl/WLE1_falcon_wing__V19.stl
cad/v19/v19r_boom_rotors/stl/WRB_hollow_wing__V19.stl
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
