Normansrule/skyforge-v18-falcon/tests/data/synthetic_bench_log.csv

# SYNTHETIC TEST LOG - not a measurement
t_ms | phase | throttle_pct | pwm_us | thrust_g | current_a | voltage_v | temp_c
0 | step | 25 | 1250 | 5.2 | 0.29 | 16.353 | 37.5
100 | step | 25 | 1250 | 7.8 | -0.11 | 16.353 | 37.5
200 | step | 25 | 1250 | 16.8 | -0.08 | 16.354 | 37.5
300 | step | 25 | 1250 | 30.6 | 0.41 | 16.343 | 37.6
400 | step | 25 | 1250 | 38.6 | 0.37 | 16.337 | 37.6
500 | step | 25 | 1250 | 48.5 | 0.53 | 16.376 | 37.6
600 | step | 25 | 1250 | 54.3 | 0.51 | 16.365 | 37.6
700 | step | 25 | 1250 | 60.9 | 0.78 | 16.349 | 37.6
800 | step | 25 | 1250 | 67.1 | 0.87 | 16.359 | 37.7
900 | step | 25 | 1250 | 72.3 | 0.50 | 16.357 | 37.7
1000 | step | 25 | 1250 | 77.2 | 0.92 | 16.354 | 37.7
1100 | step | 25 | 1250 | 86.0 | 0.81 | 16.354 | 37.7
1200 | step | 25 | 1250 | 88.7 | 0.64 | 16.348 | 37.7
1300 | step | 25 | 1250 | 88.0 | 1.30 | 16.351 | 37.8
1400 | step | 25 | 1250 | 96.3 | 1.06 | 16.349 | 37.8
1500 | step | 25 | 1250 | 90.8 | 1.17 | 16.348 | 37.8
1600 | step | 25 | 1250 | 103.0 | 0.74 | 16.348 | 37.8
1700 | step | 25 | 1250 | 108.1 | 1.32 | 16.339 | 37.8
1800 | step | 25 | 1250 | 100.3 | 1.05 | 16.360 | 37.9
1900 | step | 25 | 1250 | 108.7 | 1.14 | 16.342 | 37.9
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
