Normansrule/skyforge-v18-falcon/(commit log)

2026-09-30 SKYFORGE V18: improved BOM, budget tool, pin-by-pin wiring, interface CAD, test gates
    - bom/bom.csv with supplier links, dims, purchase gates, stage + change tags
    - tools/budget.py: running cost, mass, per-motor hover load vs CG, PASS/FIX/STOP gates
    - docs/WIRING.md + config/pinmap.csv + BENCH_ONLY ArduPilot param file
    - cad/src: motor pad on 8x8 beam, cross-clamps, cradles, EDF plate, FC TPU carrier,
    nose collar, layout reference; STEP/STL/3MF/DXF exports and layout checks
    - tools/check_repo.py + CI workflow
    Claude-Session: https://claude.ai/code/session_01CZDeaSp1gPL451UcAw7iTY
    [SF_EDF_thrust_plate_G10_2p0.dxf, SF_EDF_thrust_plate_G10_2p0.step, SF_EDF_thrust_plate_G10_2p0.stl, SF_FC_iso_carrier_TPU.3mf, SF_FC_iso_carrier_TPU.step, SF_FC_iso_carrier_TPU.stl, SF_G10_drill_templates_PLA.3mf, SF_G10_drill_templates_PLA.step]
2026-10-02 v0.2.0: rebuild around the V18 assembly; web + desktop app
    - V18 geometry extraction (90 objects), P1S placement, G10 DXFs, carbon cut list
    - Mass/CG model from V18 positions; vortex-lattice aero (validated vs AeroSandbox);
    geometry checks both sides; balance study over 576 combinations
    - Finding: CG x418 is aft of the rotor centroid (x330) and the NP band (x285-332);
    no silhouette-preserving change passes both hover and wing-borne gates
    - BOM reconciled with the V18 BOM; every item placed on the V18 model
    - Interface parts redesigned for the V18 structure and fit-checked in place
    - Harness cut list, wiring updated to V18 parts and trays
    - Thrust-stand firmware (Nano + HX711) and log ing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
    [G10_cassette_A_support_left_t2.0.dxf, G10_cassette_B_support_left_t2.0.dxf, G10_main_gear_left_t2.5.dxf, G10_motor_backing_2_t2.5.dxf, G10_motor_backing_3_t2.5.dxf, G10_motor_backing_4_t2.5.dxf, G10_motor_plate_2_t2.5.dxf, G10_motor_plate_3_t2.5.dxf]
2026-10-02 v0.3.0: V19 variants (long nose, falcon tail, forward rotors, recommended V19-R), redesigned workbench, one-command setup and publishing
    - tools/v19: configuration engine; search over 44 configurations with masses from the V19 construction;
    variant geometry from the V18 meshes (moved parts, cut panels, booms, pods, risers, hangers, well caps,
    glove, root fairings, tail booms, fins, stabiliser, elevators, nose-bay floor) with full-assembly collision
    checks against V18; generated docs/V19_VARIANTS.md
    - V19-R (wing 250 mm aft + forward rotors on booms + 0.05 m2 tail) and V19-C (wing 275 mm aft + forward
    rotors) pass every model gate; V19-A (long nose alone) and V19-B (tail alone) do not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
    [CAM_19mm_cradle__V19.stl, F3_hollow_body__V19.stl, F4_hollow_body__V19.stl, NEW_CF_rotor_boom_L_10x10x456.stl, NEW_CF_rotor_boom_L_10x10x526.stl, NEW_CF_rotor_boom_R_10x10x456.stl, NEW_CF_rotor_boom_R_10x10x526.stl, NEW_CF_tail_boom_L_8x8x490.stl]
2026-10-04 v0.4.0: V19-W - four rotors in the wing wells, pilot's-eye cockpit camera, one EDF
    - V19-W (recommended): all four lift motors in the V18 wells, wing 200 mm aft, 0.18 m2 falcon tail; under-wing
    booms carry the rear motors (rear crossrail ahead of D1) and the main gear (bolted to the rear motor backing plates);
    static margin 8.2 %, heaviest motor 26.0 %, no new collisions, every printed part fits the P1S
    - Cockpit: FPV camera at a pilot's eye point on a printed seat under a vacuum-formed clear canopy; GPS off the nose
    - Cruise engine: single Freewing E7206 kept (vendor data comparison with twin 50 mm in the V19 document)
    - Web app: Pilot view with HUD; V19-W in the switcher; V19-R slug re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
    [CAM_19mm_cradle__V19.stl, F3_hollow_body__V19.stl, F4_hollow_body__V19.stl, NEW_CF_rotor_boom_L_10x10x245.stl, NEW_CF_rotor_boom_L_10x10x456.stl, NEW_CF_rotor_boom_L_10x10x523.stl, NEW_CF_rotor_boom_L_10x10x526.stl, NEW_CF_rotor_boom_R_10x10x245.stl]
2026-10-06 v0.5.0: V19-S - four rotors in the wings without the big tail (stoop wing + falcon crest)
    - New recommended variant V19-S: all four lift rotors in the V18 wing wells, wing group 235 mm aft,
    outer falcon panels swept 300 mm back at the wrist on swept carbon wrist spars, a 0.07 m2 falcon
    crest on the V18 fin tips (4 deg LE down, 30 % elevator, one slim servo), battery in the V18 tray.
    2832 g, 1188 mm, SM 8.0/13.9 %, heaviest motor 25.5 %, trim -1.7/-8.1 deg, no new collisions.
    - Search family S (14 rows, fixed-crest rows kept for the record); pick keeps trim margin.
    - Fixes: tail incidence/position in the aero cache key; viewer maps sanitized GLB node names back
    to part names; no F4 sl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
    [CF_crossrail_450_10x10x820__V19.stl, F3_hollow_body__V19.stl, FIN_L__V19.stl, FIN_R__V19.stl, NEW_CF_crest_spar_L_6x4x325.stl, NEW_CF_crest_spar_R_6x4x325.stl, NEW_CF_rotor_boom_L_10x10x245.stl, NEW_CF_rotor_boom_R_10x10x245.stl]
2026-10-06 v0.6.0: hover first - CG on the centre of the four motors; V19-F, S and G looks
    - Battery slides up to 15 mm in the V18 tray so the CG sits where the motor diagonals cross;
    the stoop-family pick requires the CG within 3 mm of that point.
    - Three passing looks on the four-rotors-in-the-wells layout: V19-F deep stoop (340 mm, slim
    0.055 m2 45 deg crest; recommended, CG 0.2 mm off, motors 24.9-25.1 %, SM 7.5/13.3 %),
    V19-S (300 mm, 0.07 m2 crest) and V19-G (300 mm, slim crest, concept).
    - Crest leading edge tied to the fin tops for any sweep.
    - Web app: hover frame (motor rectangle + diagonals) replaces the rotor bar; ruler reads
    "rotor centre"; screenshots reset the camera between view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
    [CF_crossrail_450_10x10x820__V19.stl, F3_hollow_body__V19.stl, FIN_L__V19.stl, FIN_R__V19.stl, NEW_CF_crest_spar_L_6x4x325.stl, NEW_CF_crest_spar_L_6x4x388.stl, NEW_CF_crest_spar_L_6x4x405.stl, NEW_CF_crest_spar_R_6x4x325.stl]
